Zyrter/super-osd/hardware/V3.25 Lite/note about refdeses.txt

Due to a bit of screwup while designing this version, I numbered all resistors from R16 and all capacitors from C18. There are no missing components, it was just a mistake on my part. I'm not too bothered by this but I will fix it in future versions.

Tom
