Zyrter/super-osd/hardware/Basic Main Board Schematic.png

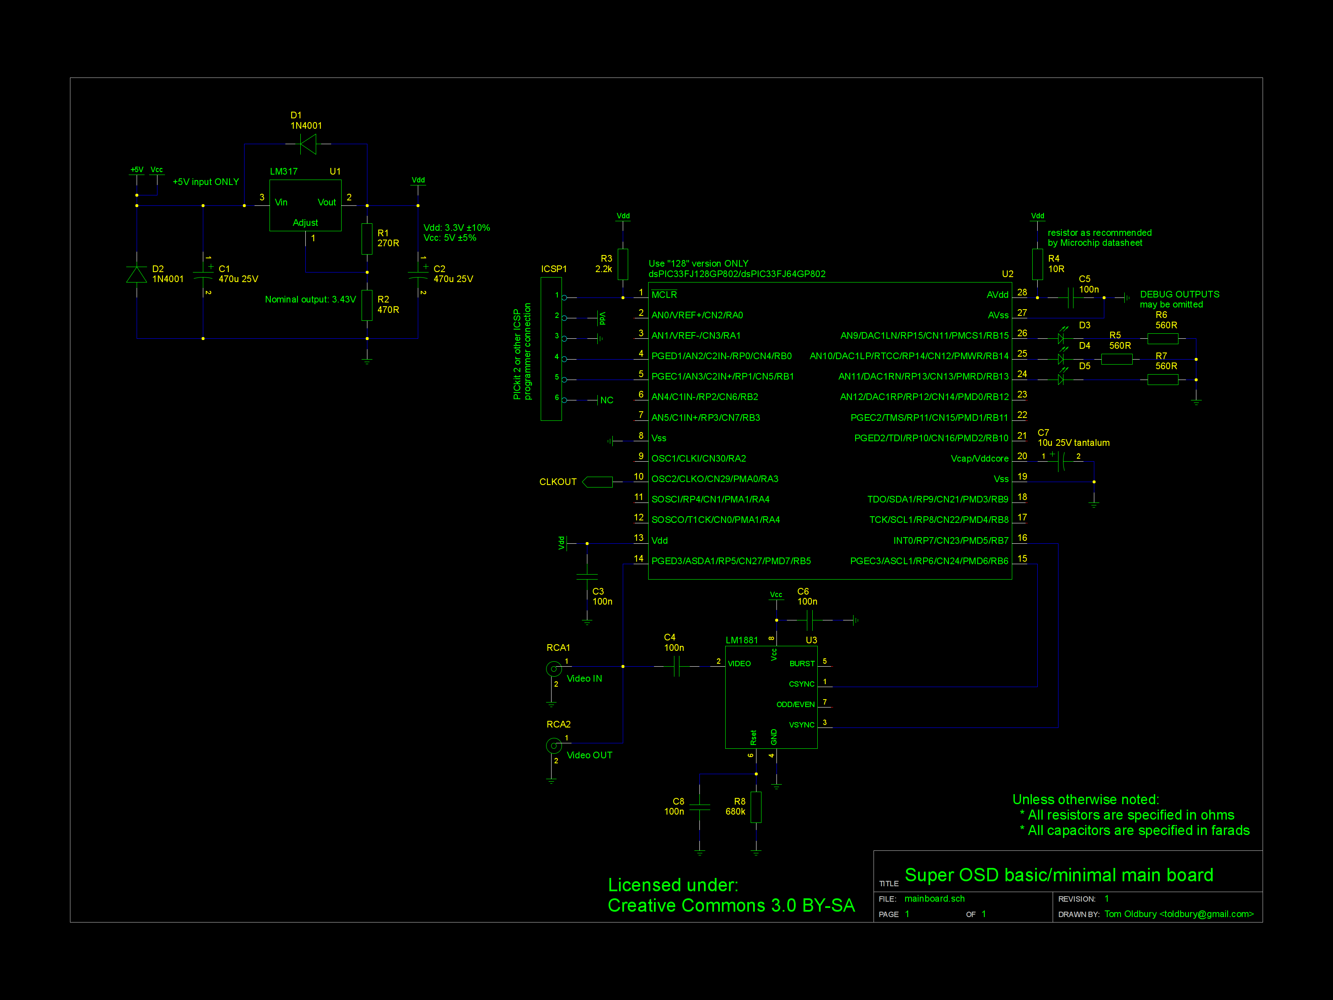
hardware/Basic Main Board Schematic.png
