Zyrter/super-osd/hardware/Other Stuff/Gaming Radio/gaming-radio.png

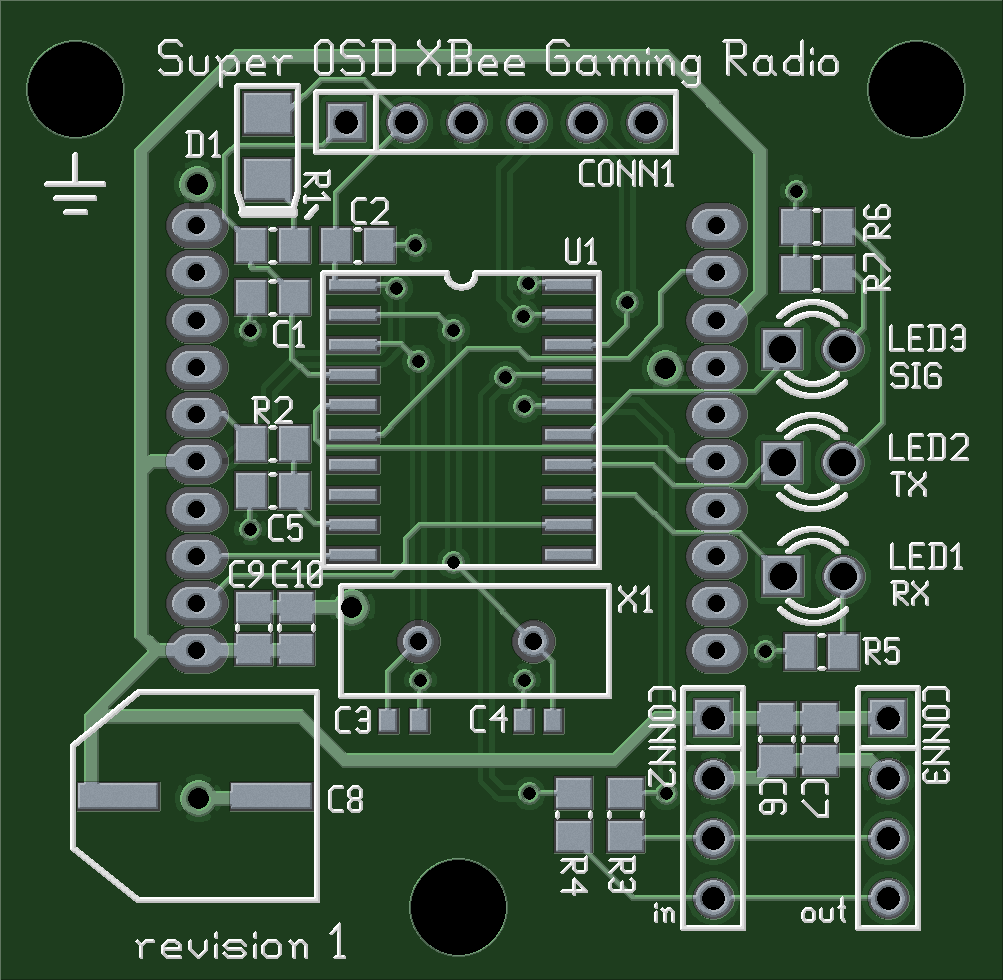
hardware/Other Stuff/Gaming Radio/gaming-radio.png
