Zyrter/super-osd/hardware/Other Stuff/Gaming Radio/radio.png

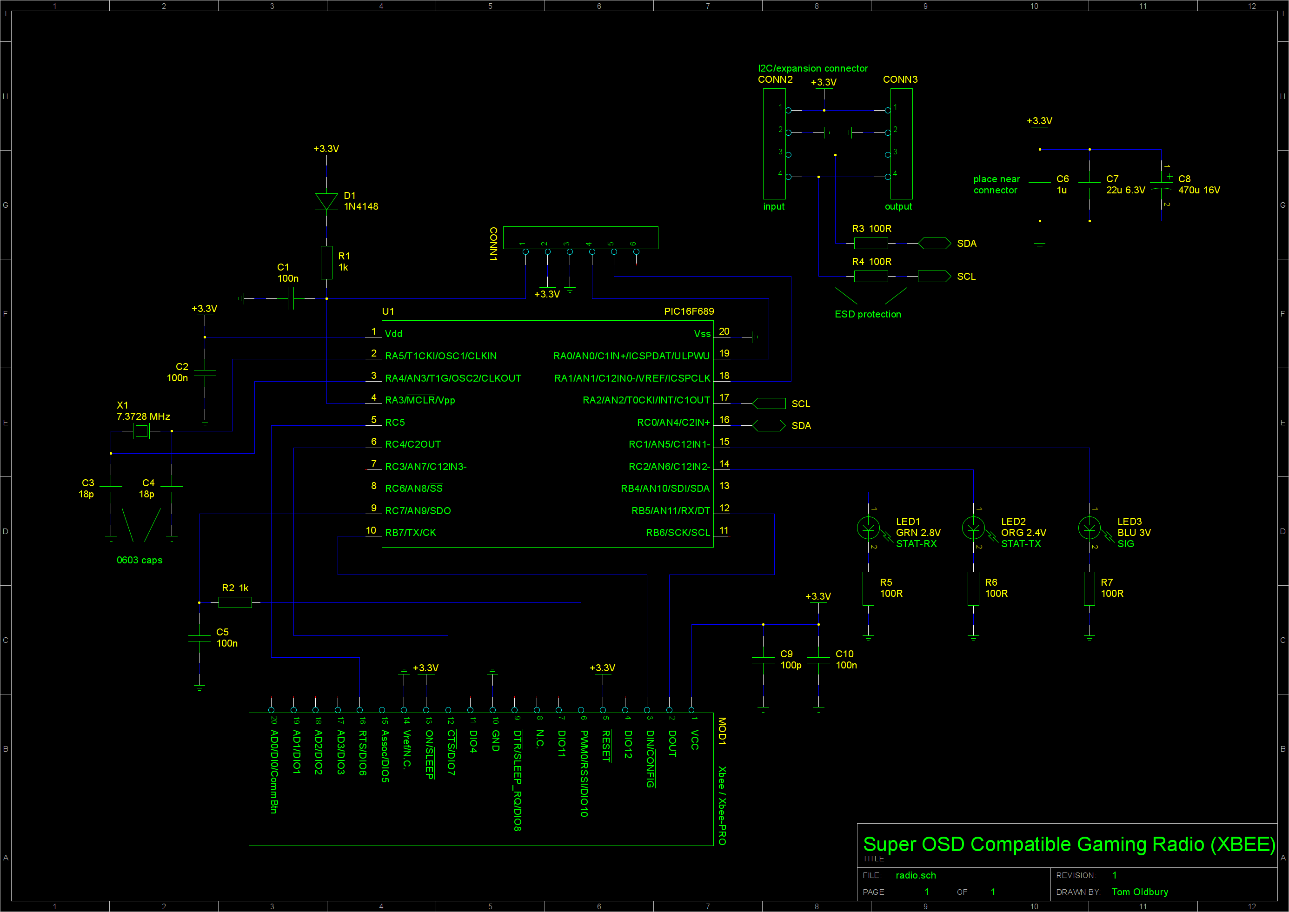
hardware/Other Stuff/Gaming Radio/radio.png
