Zyrter/super-osd/hardware/V2 (FPV version)/FPV_version_analog_inputs.png

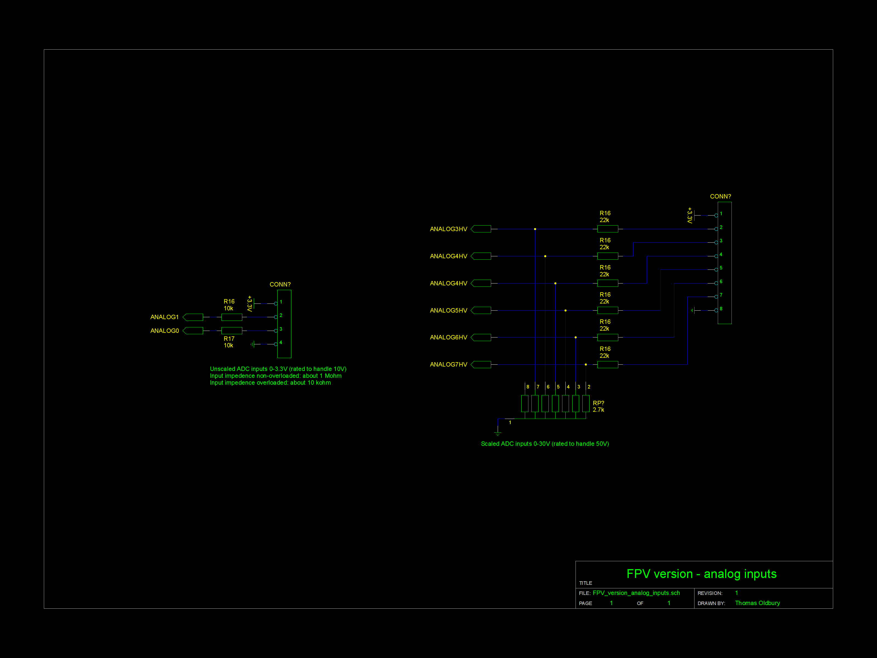
hardware/V2 (FPV version)/FPV_version_analog_inputs.png
