Zyrter/super-osd/hardware/V2 (FPV version)/FPV_version_external_interface.png

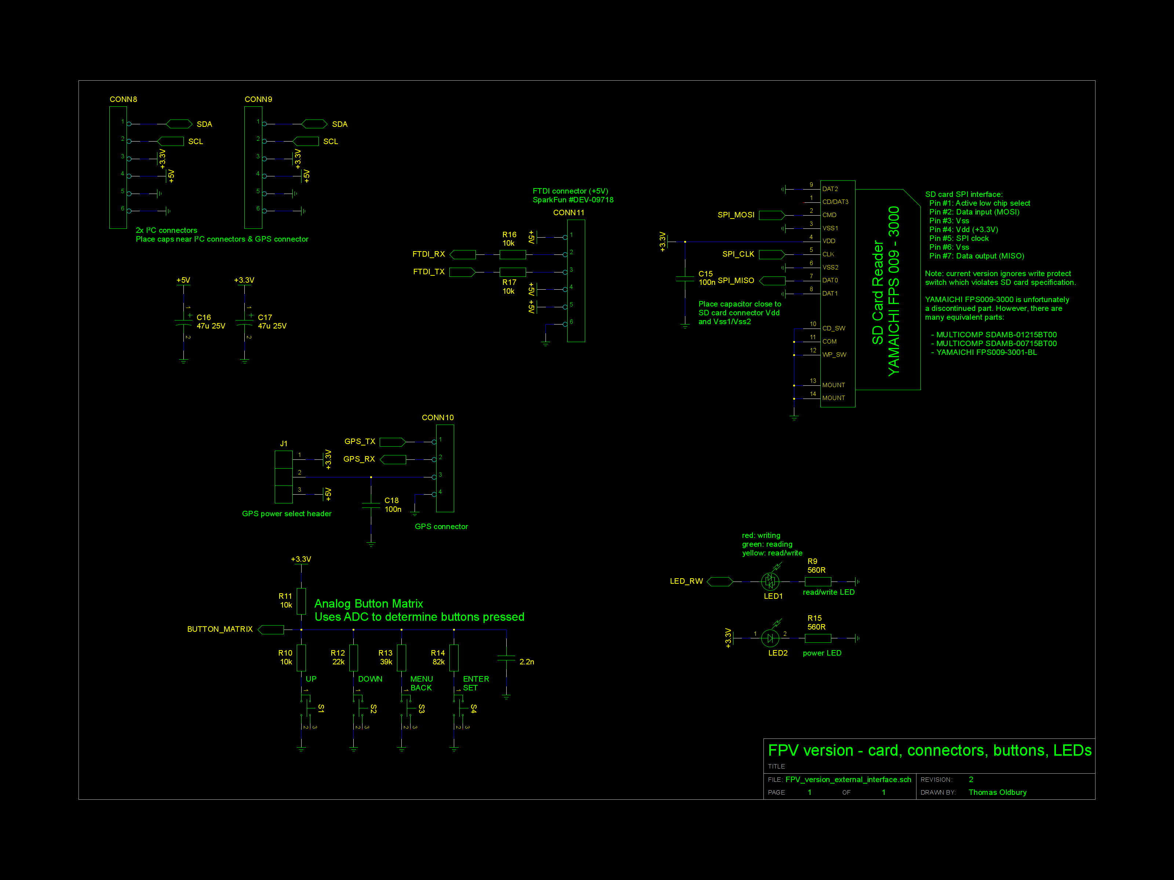
hardware/V2 (FPV version)/FPV_version_external_interface.png
