Zyrter/super-osd/hardware/V2 (FPV version)/FPV_version_PIC18.png

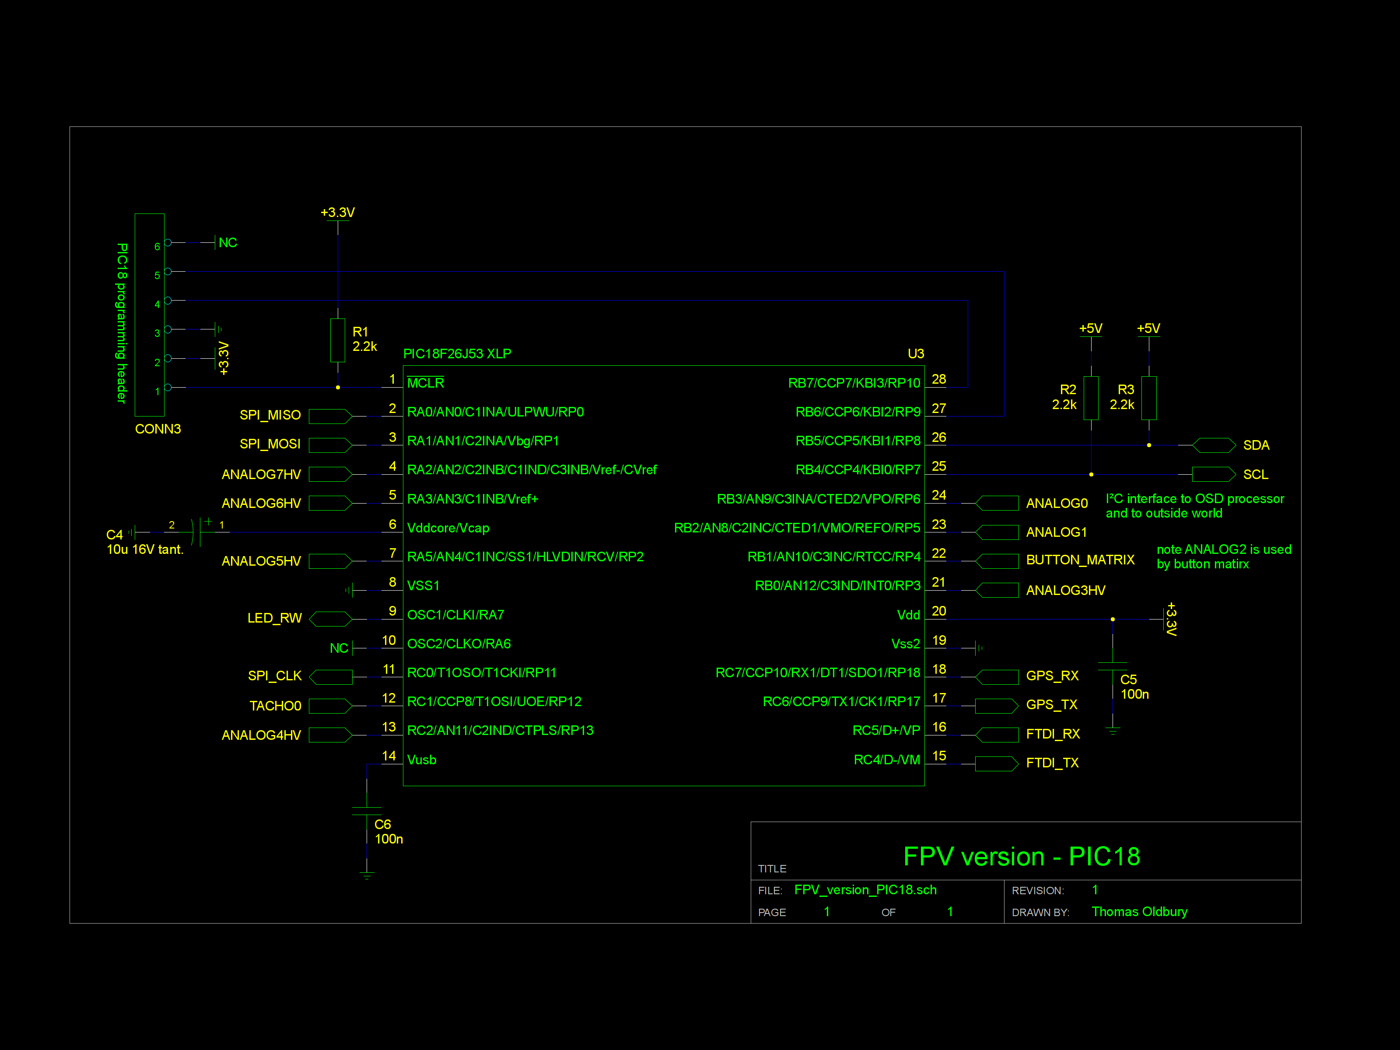
hardware/V2 (FPV version)/FPV_version_PIC18.png
