Zyrter/super-osd/hardware/V2 (FPV version)/FPV_version_video_core.png

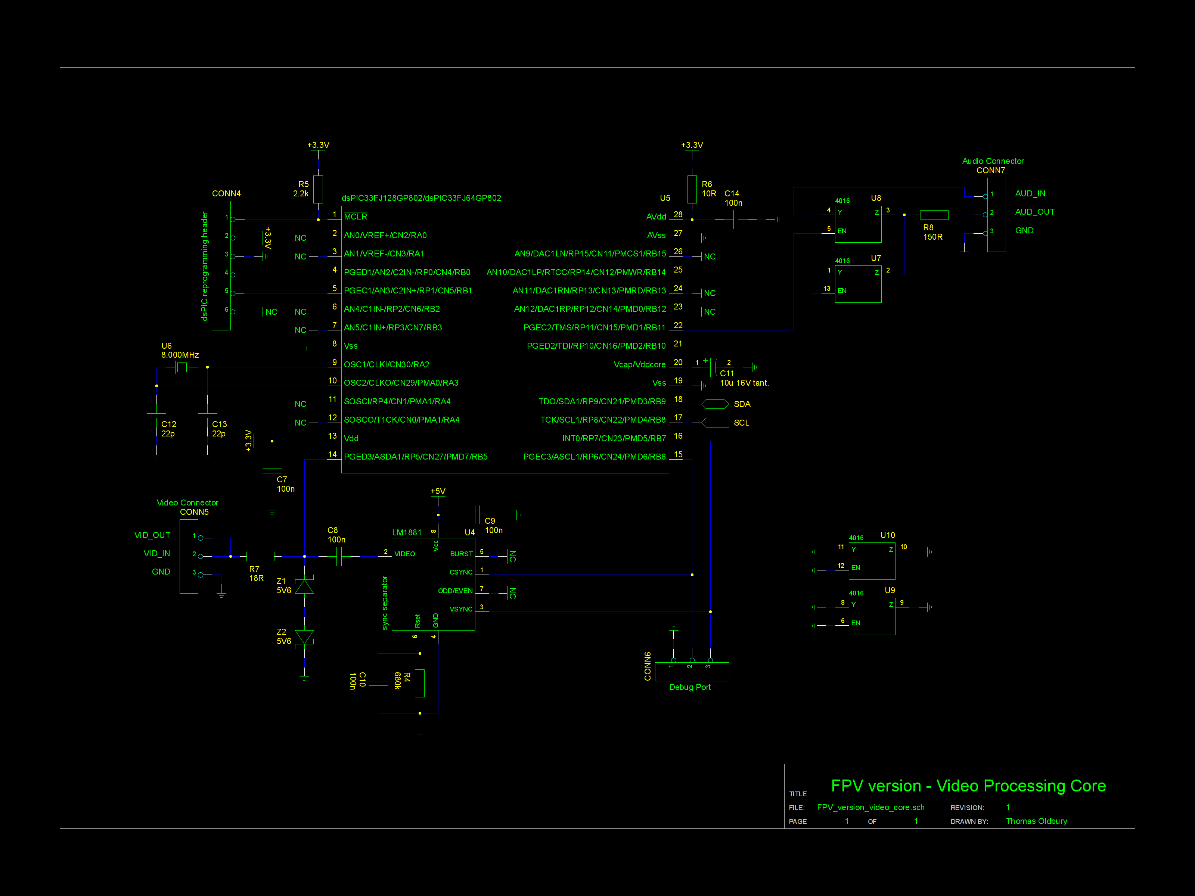
hardware/V2 (FPV version)/FPV_version_video_core.png
