Zyrter/super-osd/hardware/V2 (FPV version)/Power_supply_section.png

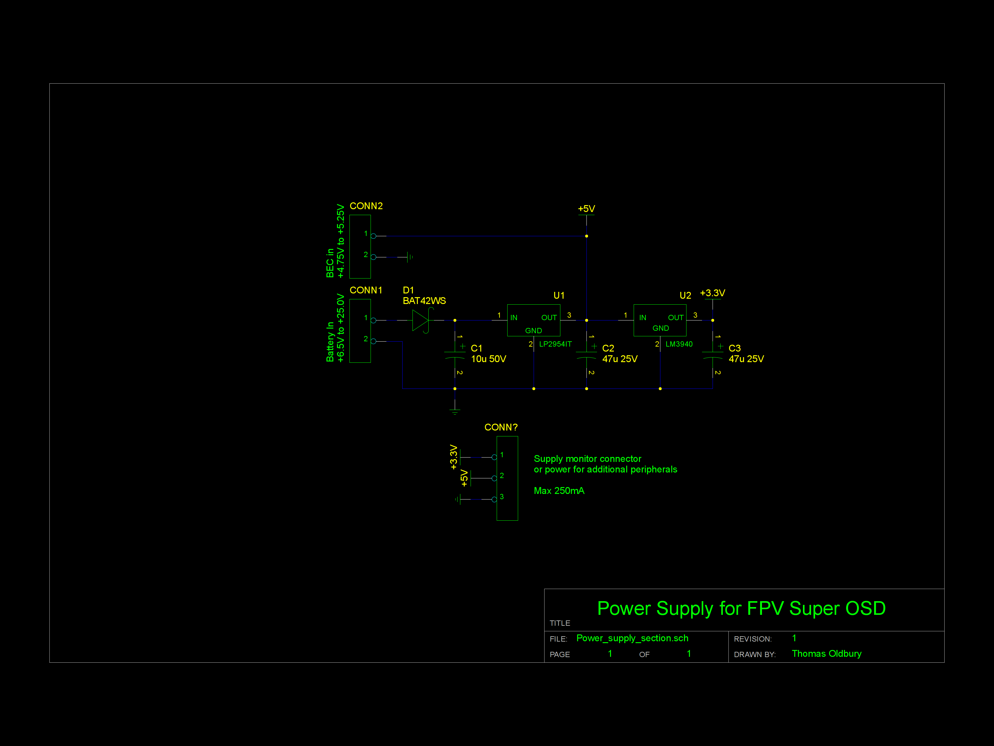
hardware/V2 (FPV version)/Power_supply_section.png
