Zyrter/super-osd/hardware/V2B (Final-Prototype)/FPV_version_analog_inputs.png

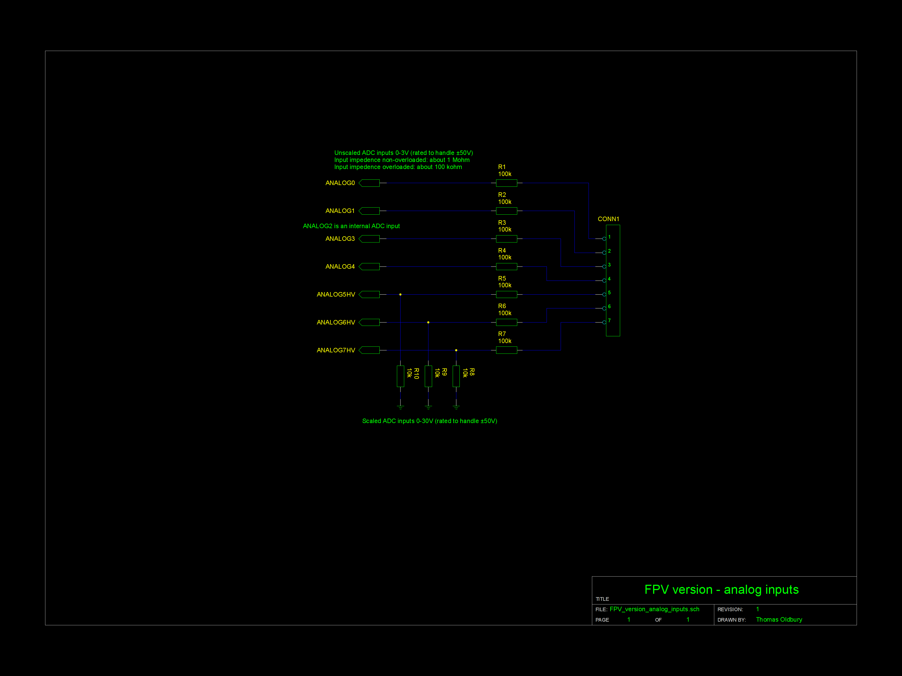
hardware/V2B (Final-Prototype)/FPV_version_analog_inputs.png
