Zyrter/super-osd/hardware/V2B (Final-Prototype)/FPV_version_external_interface.png

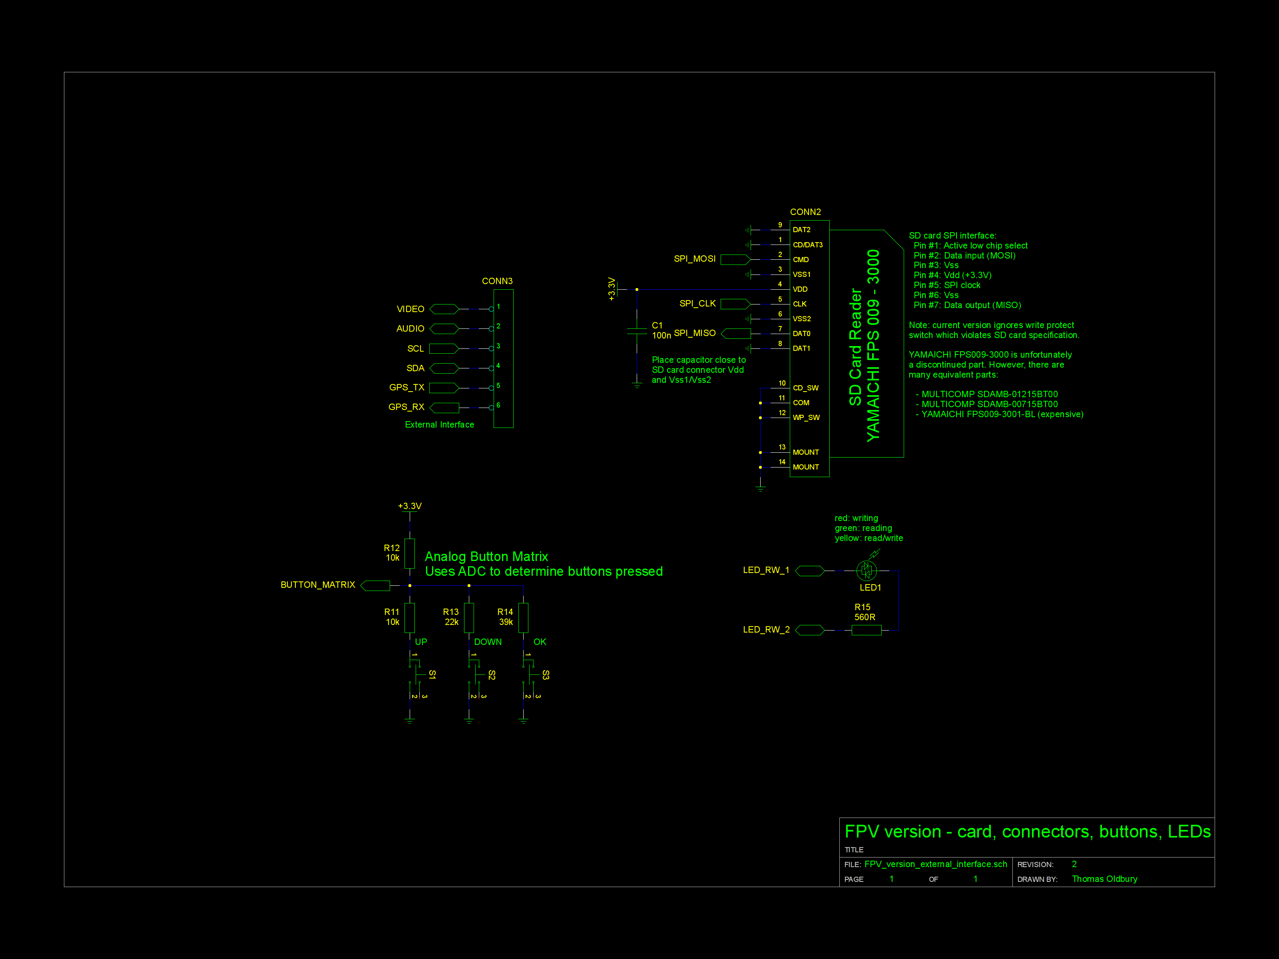
hardware/V2B (Final-Prototype)/FPV_version_external_interface.png
