Zyrter/super-osd/hardware/V2B (Final-Prototype)/FPV_version_video_core.png

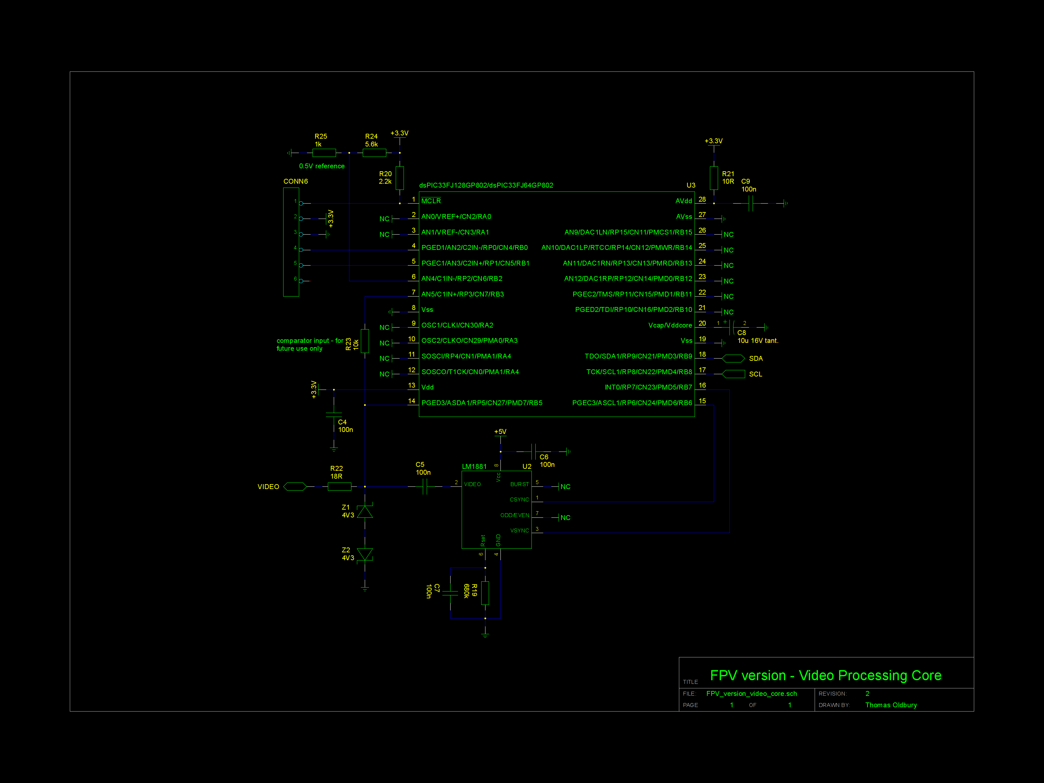
hardware/V2B (Final-Prototype)/FPV_version_video_core.png
