Zyrter/super-osd/hardware/V2B (Final-Prototype)/Power_supply_section.png

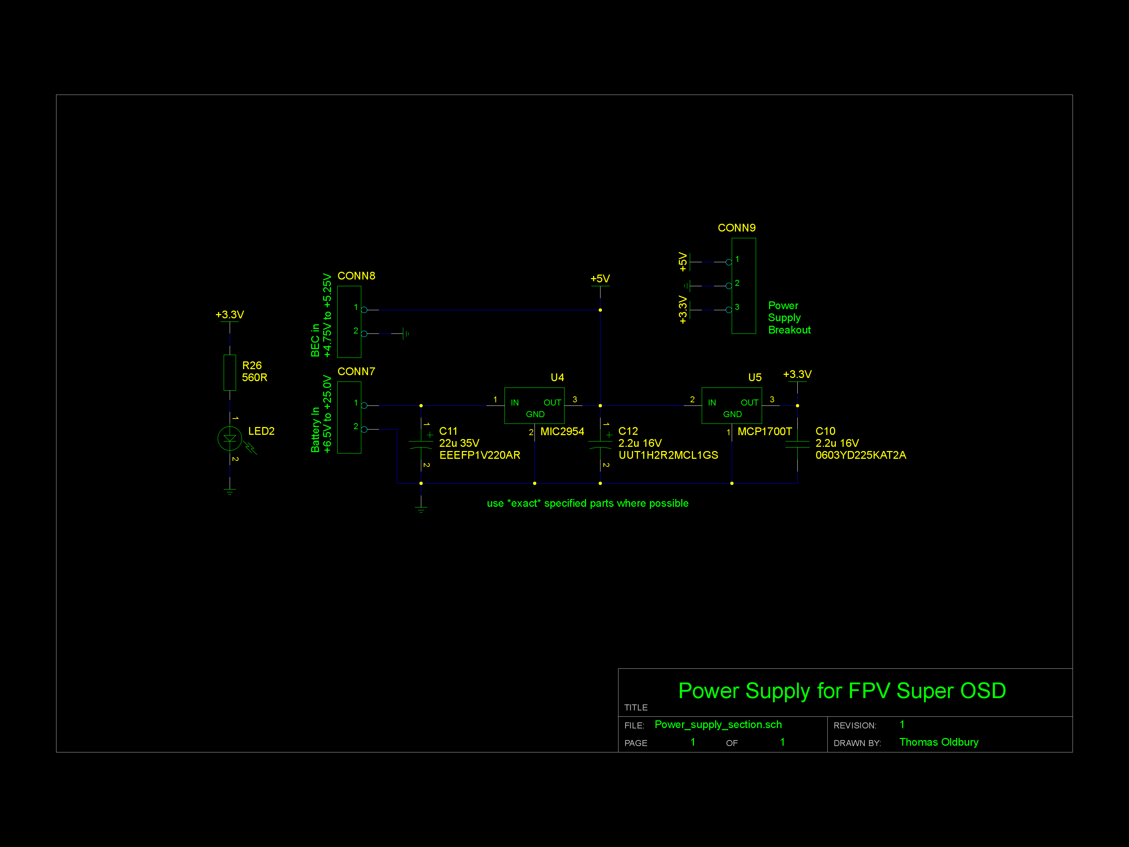
hardware/V2B (Final-Prototype)/Power_supply_section.png
