Zyrter/super-osd/hardware/V2B (Final-Prototype)/v2b_bottom.png

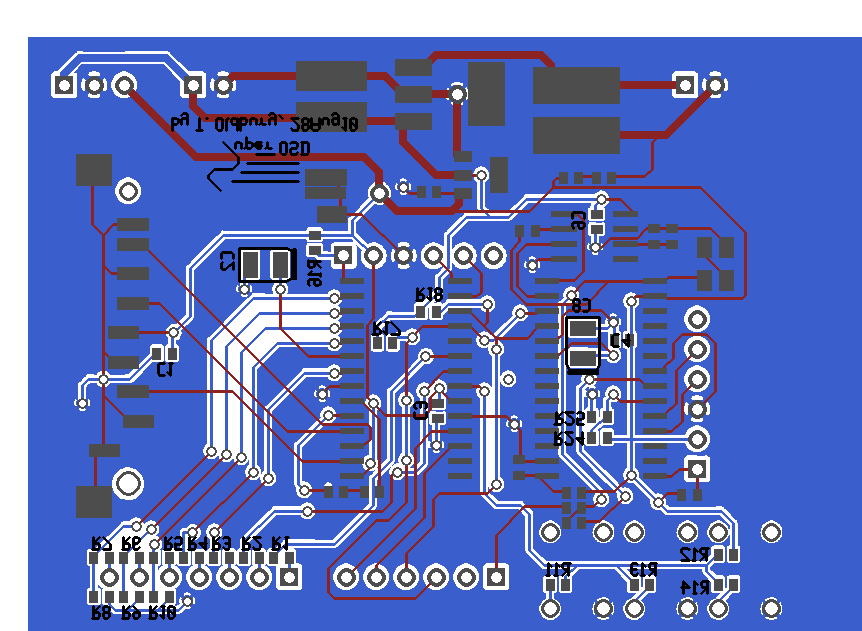
hardware/V2B (Final-Prototype)/v2b_bottom.png
