Zyrter/super-osd/hardware/V2B (Final-Prototype)/v2b_top.png

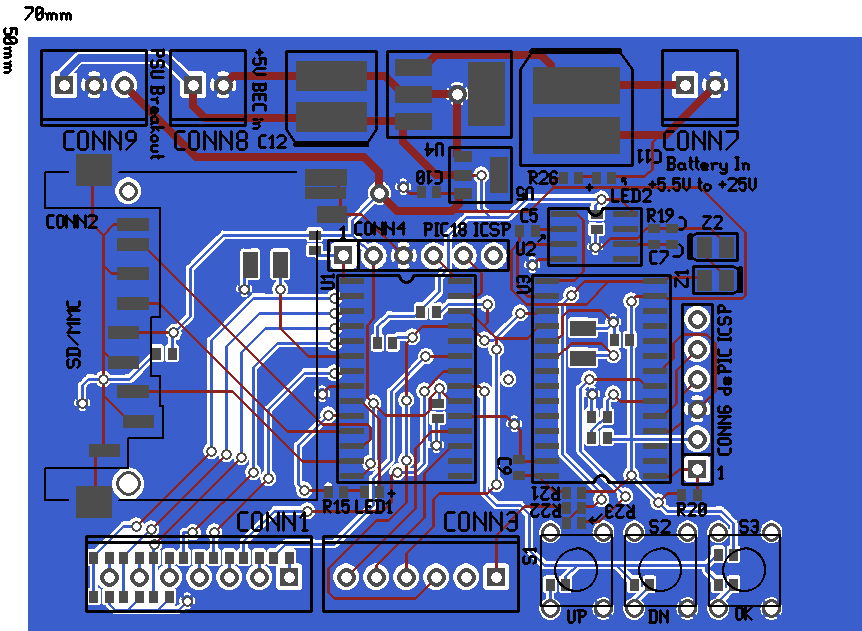
hardware/V2B (Final-Prototype)/v2b_top.png
