Zyrter/super-osd/hardware/V3.25 Lite/buttons-and-illumination.png

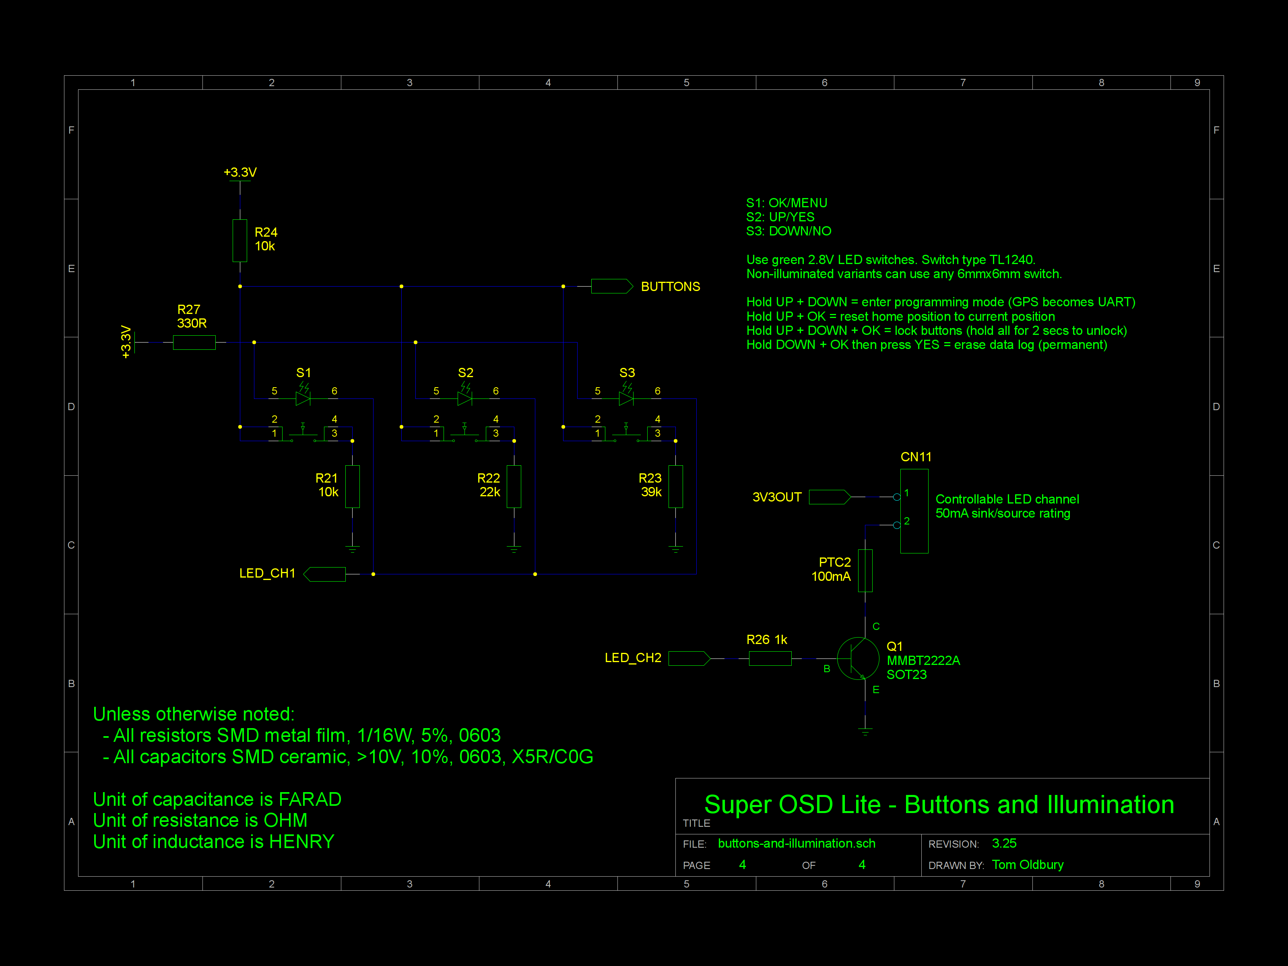
hardware/V3.25 Lite/buttons-and-illumination.png
