Zyrter/super-osd/hardware/V3.25 Lite/mcu.png

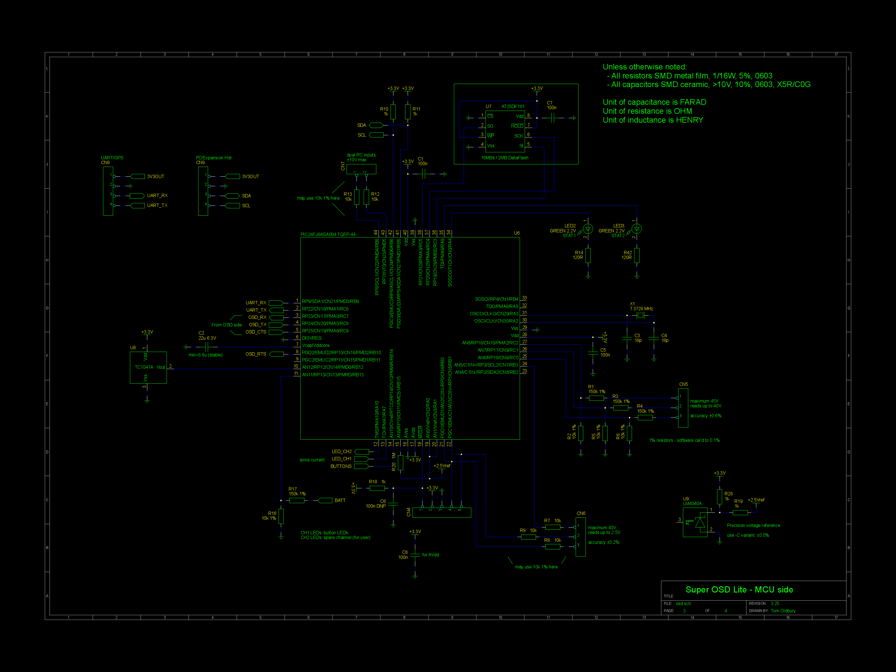
hardware/V3.25 Lite/mcu.png
