Zyrter/super-osd/hardware/V3.25 Lite/osd.png

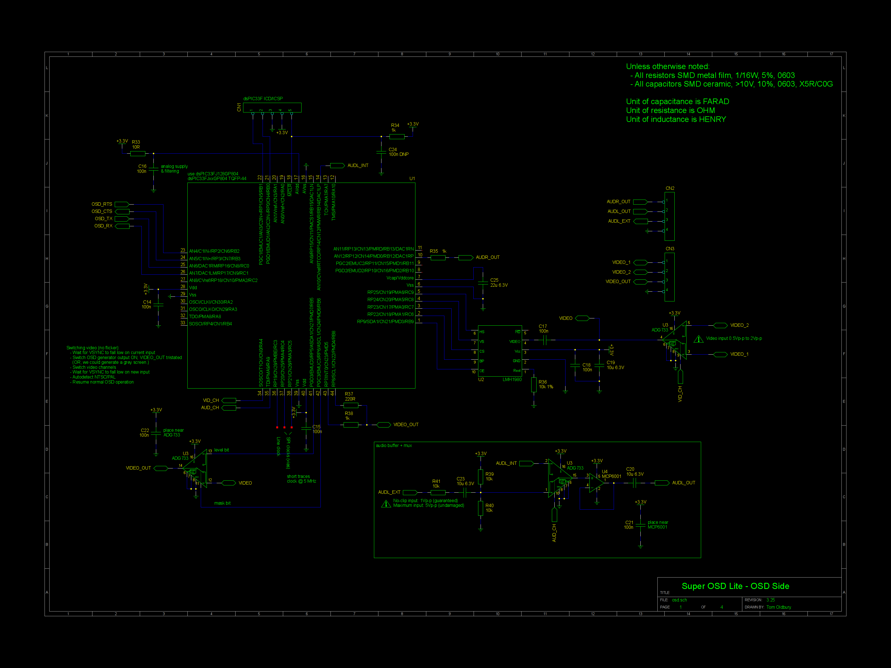
hardware/V3.25 Lite/osd.png
