Zyrter/super-osd/hardware/V3.25 Lite/pcb-v3.25-lite.top.png

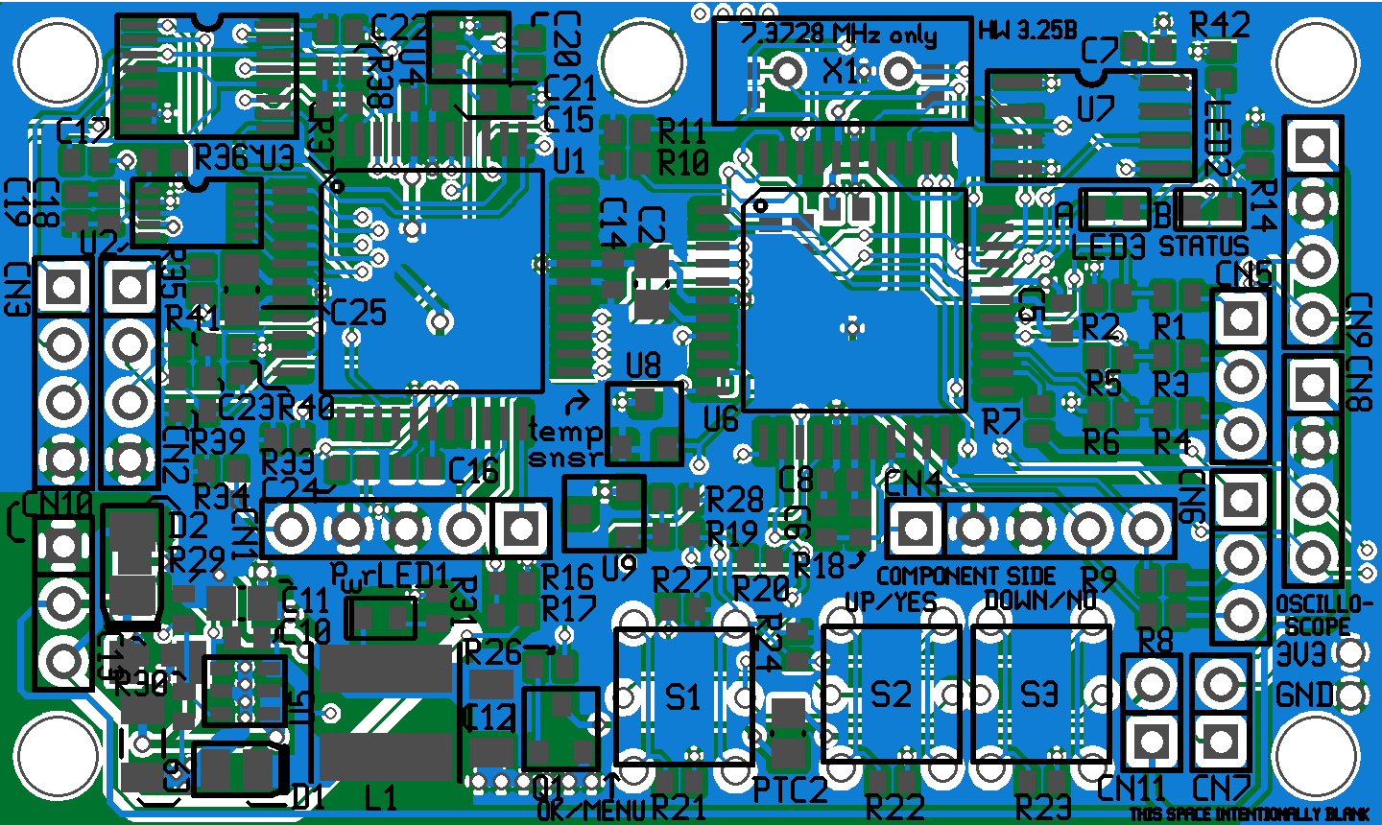
hardware/V3.25 Lite/pcb-v3.25-lite.top.png
