Zyrter/super-osd/hardware/V3.25 Lite/power.png

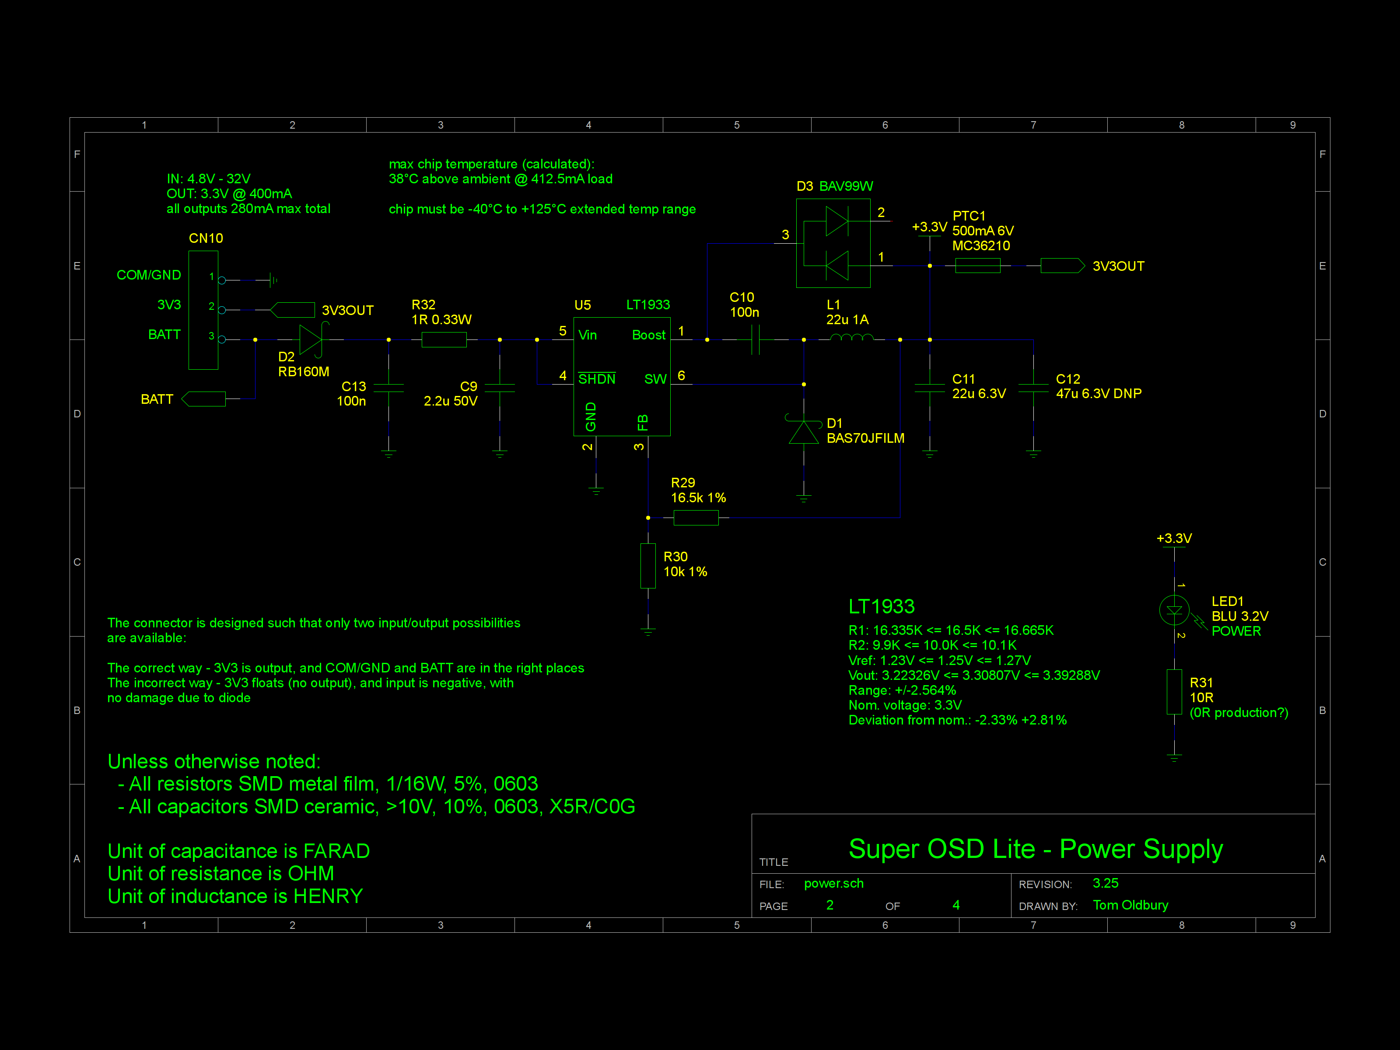
hardware/V3.25 Lite/power.png
