Zyrter/super-osd/hardware/V2B (Final-Prototype)/bom.ods

BILL OF MATERIALS FOR (r4: FPV version)
SUPPLIER: FARNELL (UK) EXCEPT WHERE NOTED
FOR SMALL QUANTITIES (<10 units) ONLY
RefDes | Value | Footprint | Unit price (inc VAT) | Order Code | Notes
C1 | 100n | 0603 | £0.0050 | 1759016 | Min order 100
C2 | 10u 16V tant. | EIA3216 | £0.4700 | 1462407 | High reliability, down to -55°C, low ESR ~3ohm
C3 | 100n | 0603 | £0.0050 | 1759016 | Min order 100
C4 | 100n | 0603 | £0.0050 | 1759016 | Min order 100
C5 | 100n | 0603 | £0.0050 | 1759016 | Min order 100
C6 | 100n | 0603 | £0.0050 | 1759016 | Min order 100
C7 | 100n | 0603 | £0.0050 | 1759016 | Min order 100
C8 | 10u 16V tant. | EIA3216 | £0.4700 | 1462407 | High reliability, down to -55°C, low ESR ~3ohm
C9 | 100n | 0603 | £0.0050 | 1759016 | Min order 100
C10 | 2.2u 16V | 0603 | £0.6500 | 1458897 | As specified: 0603YD225KAT2A
C11 | 22u 35V | SME5 | £0.4400 | 1539494 | As specified: EEEFP1V220AR
C12 | 2.2u 16V | SME4 | £0.4000 | 8823251 | As specified: UUT1H2R2MCL1GS
CONN1 |  | MTA100_7 | £1.3200 | 1272217
CONN2 |  | sdcard-1 | £1.0100 | 9186140 | MULTICOMP – SDAMB-01215BT00, low cost SD card holder
CONN3 |  | MTA100_6 | £0.8500 | 1272213
CONN4 |  | JUMPER6 | £0.4800 | 9731113 | Min order 10; Quality Molex part(?) (HEADER, SQUARE PIN, 0.1", 6WAY)
CONN6 |  | JUMPER6 | £0.4800 | 9731113 | Min order 10; Quality Molex part(?) (HEADER, SQUARE PIN, 0.1", 6WAY)
CONN7 |  | MTA100_2 | £0.3050 | 1199343
CONN8 |  | MTA100_2 | £0.2980 | 1325021
CONN9 |  | MTA100_3 | £0.2980 | 1325021
LED1 |  | 0603 | £0.1060 | 1652080 | Bicolour not yet available – chosen RED instead to indicate writing
LED2 |  | 0603 | £0.1060 | 1652080 | Red LED for power
R1 | 10k | 0603 | £0.0230 | 9330402 | Min order 50, input protection resistor, tolerance not an issue (±5% or better)
R2 | 10k | 0603 | £0.0230 | 9330402 | Min order 50, input protection resistor, tolerance not an issue (±5% or better)
R3 | 10k | 0603 | £0.0230 | 9330402 | Min order 50, input protection resistor, tolerance not an issue (±5% or better)
R4 | 10k | 0603 | £0.0230 | 9330402 | Min order 50, input protection resistor, tolerance not an issue (±5% or better)
R5 | 100k | 0603 | £0.4700 | 1577632 | Min order 5, tolerance is ±0.1% (R5..R10 used as precision dividers for voltage input)
R6 | 100k | 0603 | £0.4700 | 1577632 | Min order 5, tolerance is ±0.1% (R5..R10 used as precision dividers for voltage input)
R7 | 100k | 0603 | £0.4700 | 1577632 | Min order 5, tolerance is ±0.1% (R5..R10 used as precision dividers for voltage input)
R8 | 10k | 0603 | £0.4700 | 1577619 | Min order 5, tolerance is ±0.1% (R5..R10 used as precision dividers for voltage input)
R9 | 10k | 0603 | £0.4700 | 1577619 | Min order 5, tolerance is ±0.1% (R5..R10 used as precision dividers for voltage input)
R10 | 10k | 0603 | £0.4700 | 1577619 | Min order 5, tolerance is ±0.1% (R5..R10 used as precision dividers for voltage input)
R11 | 10k | 0603 | £0.0230 | 9330402 | Min order 50, ±5% or better
R12 | 10k | 0603 | £0.0230 | 9330402 | Min order 50, ±5% or better
R13 | 22k | 0603 | £0.0230 | 9330828 | Min order 50, ±5% or better
R14 | 39k | 0603 | £0.0120 | 9332111 | Min order 50, ±5% or better
R15 | 560R | 0603 | £0.0120 | 9332200 | Min order 50, ±5% or better
R16 | 2.2k | 0603 | £0.0230 | 9330810 | Min order 50, ±5% or better
R17 | 2.2k | 0603 | £0.0230 | 9330810 | Min order 50, ±5% or better
R18 | 2.2k | 0603 | £0.0230 | 9330810 | Min order 50, ±5% or better
R19 | 680k | 0603 | £0.0230 | 9331476 | Min order 50, ±5% or better
R20 | 2.2k | 0603 | £0.0230 | 9330810 | Min order 50, ±5% or better
R21 | 10R | 0603 | £0.0230 | 9330429 | Min order 50, ±5% or better
R22 | 18R | 0603 | £0.0120 | 9331840 | Min order 50, ±5% or better
R23 | 10k | 0603 | £0.0230 | 9330402 | Min order 50, ±5% or better
R24 | 5.6k | 0603 | £0.0230 | 9331352 | Min order 50, ±5% or better
R25 | 1k | 0603 | £0.0230 | 9330380 | Min order 50, ±5% or better
R26 | 560R | 0603 | £0.0120 | 9332200 | Min order 50, ±5% or better
S1 |  | SPDT_button | £0.2600 | 1217773 | High reliability through-hole tactile Schurter switches, 5mm, with land pattern (6.5mmx4.5mm)
S2 |  | SPDT_button | £0.2600 | 1217773 | High reliability through-hole tactile Schurter switches, 5mm, with land pattern (6.5mmx4.5mm)
S3 |  | SPDT_button | £0.2600 | 1217773 | High reliability through-hole tactile Schurter switches, 5mm, with land pattern (6.5mmx4.5mm)
U1 |  | SO28 | £2.2500 | PIC18F26J53-I/SO | Order from Microchip Direct
U2 |  | SO8 | £2.6500 | 9493468 | Sync sep (LM1881)
U3 |  | SO28 | £3.7600 | DSPIC33FJ128GP802-E/SO | Order from Microchip Direct
U4 |  | SOT223 | £2.2300 | 1556741 | +5V regulator
U5 |  | SOT89 | £0.2500 | MCP1700T-3302E/MB | Order from Microchip Direct
Z1 | 4V3 | SOD323 | £0.0760 | 8735697 | Min order 10, zener, 300mW dissipation
Z2 | 4V3 | SOD323 | £0.0760 | 8735697 | Min order 10, zener, 300mW dissipation
