Zyrter/super-osd/hardware/Other Stuff/Factory Calibrator/cal-board.png

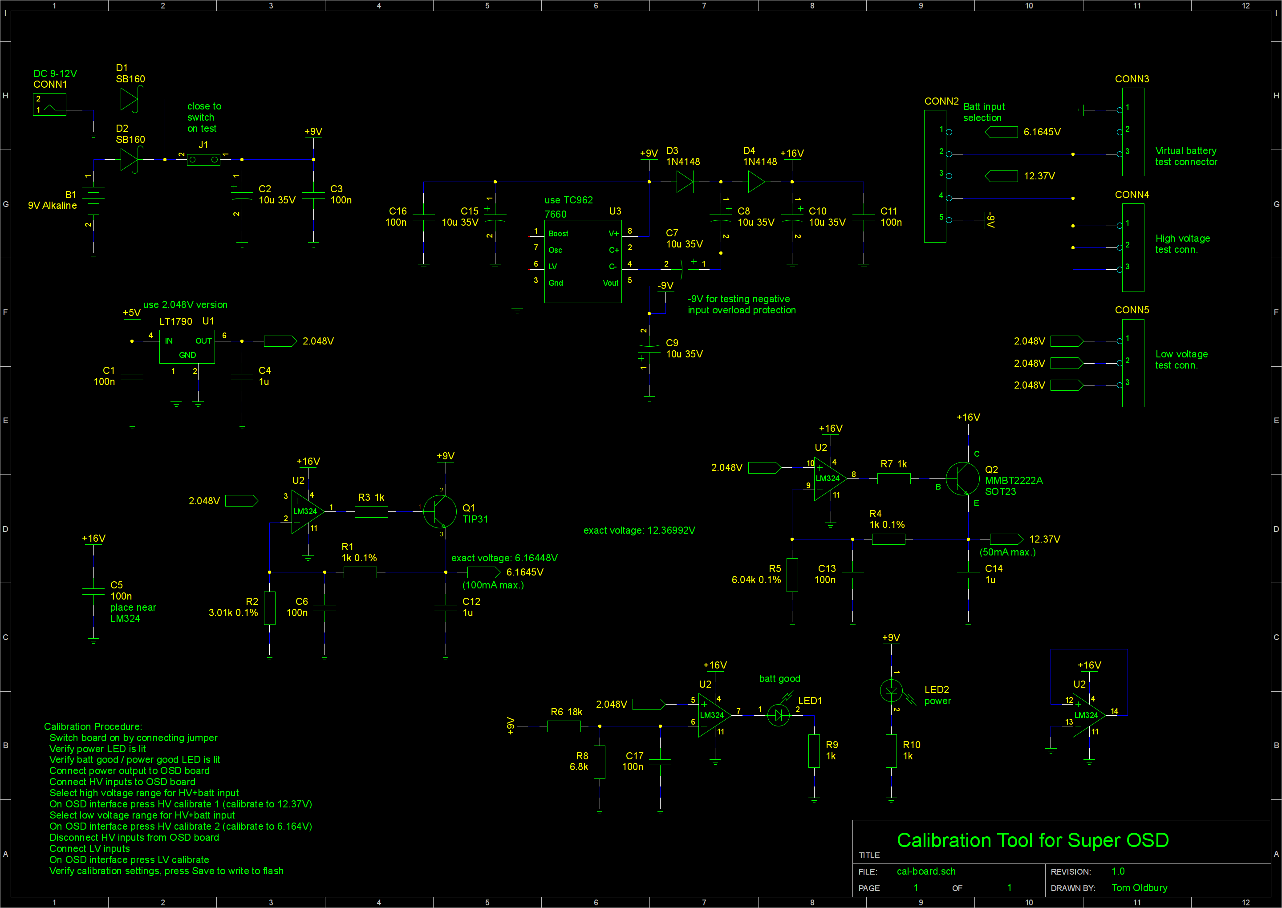
hardware/Other Stuff/Factory Calibrator/cal-board.png
