Zyrter/super-osd/hardware/Other Stuff/Factory Calibrator/v1.png

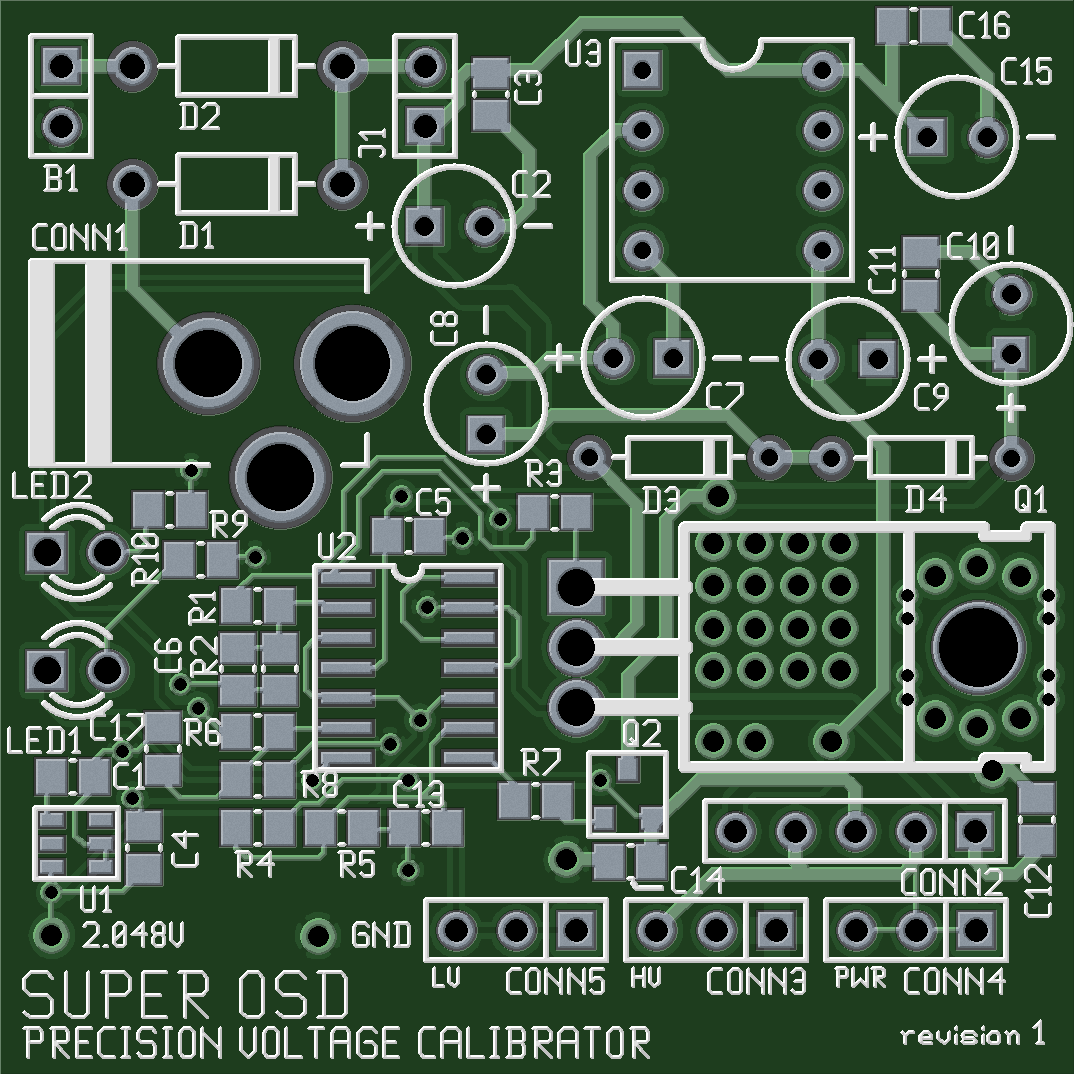
hardware/Other Stuff/Factory Calibrator/v1.png
