Zyrter/super-osd/(list of files, drawings)

Other design files:
hardware/Other Stuff/Factory Calibrator/v1.pcb
hardware/Other Stuff/Gaming Radio/gaming-radio.pcb
hardware/V2 (FPV version)/PCBs/FPV_version.pcb
hardware/V2B (Final-Prototype)/v2b.pcb
hardware/V3 Lite/pcb-v3-lite.pcb
hardware/V3.2 Lite/pcb-v3-lite.pcb
hardware/V3.3 Lite/pcb-v3.3-lite.pcb
hardware/V3.25 Lite/pcb-v3.25-lite.pcb
