Zyrter/super-osd/src-new/V3.2/gfx.c

/**
 * Super OSD, software revision 3
 * Copyright (C) 2010 Thomas Oldbury
 *
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
 * You should have received a copy of the GNU General Public License along
 * with this program; if not, write to the Free Software Foundation, Inc.,
 * 51 Franklin Street, Fifth Floor, Boston, MA 02110-1301 USA.
 */

// used by some debug code
long int delaytmp;
long int delayhowlong; 

#include "gfx.h"
#include "useful.h"
#include "fonts.h"

#include <stdlib.h>
#include <ctype.h>

/**
 * The GFX files handle the management of the display surfaces. 
 * They implement the basic drawing functions and the display
 * buffers. But, they do not handle the actual OSD output or 
 * timing; that is managed by the OSD files.
 */

// Define the buffers.
// For 256x192 pixel mode:
//   buffer0_level/buffer0_mask becomes buffer_level; and 
//   buffer1_level/buffer1_mask becomes buffer_mask;
// For 192x128 pixel mode, allocations are as the names are written.
// divide by 8 because two bytes to a word.
// Must be allocated in one block, so it is in a struct.
struct _buffers
{
	uint16_t buffer0_level[BUFF_TOTAL_SIZE / 8] FAR;
	uint16_t buffer0_mask[BUFF_TOTAL_SIZE / 8] FAR;
	uint16_t buffer1_level[BUFF_TOTAL_SIZE / 8] FAR;
	uint16_t buffer1_mask[BUFF_TOTAL_SIZE / 8] FAR;
} buffers FAR;
// Remove the struct definition (makes it easier to write for.)
#define		buffer0_level	(buffers.buffer0_level)
#define		buffer0_mask	(buffers.buffer0_mask)
#define		buffer1_level	(buffers.buffer1_level)
#define		buffer1_mask	(buffers.buffer1_mask)

int disp_width, disp_height, disp_mode;
int buff_words;

// We define pointers to each of these buffers.
uint16_t *draw_buffer_level;
uint16_t *draw_buffer_mask;
uint16_t *disp_buffer_level;
uint16_t *disp_buffer_mask;

// Memory test.
int memseed;

// Do we have VSYNC, and are we looking for it? (osd.c sets have_vsync_refresh, gfx.c clears it.)
// Some graphics work better locked to the frame rate, so we have functions to wait for vsync.
int use_vsync, have_vsync_refresh;

/**
 * init_osd: Initialize the OSD buffers and internal 
 * state variables.
 */
void init_gfx(int mode)
{
	// mode 0: hires
	if(mode == 0)
	{
		draw_buffer_level = buffer0_level;
		draw_buffer_mask = buffer1_level; // see above
		disp_buffer_level = draw_buffer_level;
		disp_buffer_mask = draw_buffer_mask;
		buff_words = BUFF_TOTAL_SIZE / 4;
		disp_width = 240;
		disp_height = 208; 
		disp_mode = 0;
	}
	// mode 1: lores
	else if(mode == 1)
	{
		draw_buffer_level = buffer0_level;
		draw_buffer_mask = buffer0_mask;
		disp_buffer_level = buffer1_level;
		disp_buffer_mask = buffer1_mask;
		buff_words = BUFF_TOTAL_SIZE / 8;
		disp_width = 192;
		disp_height = 128; 
		disp_mode = 1;
	}
	// Fill the buffers with empty data, in case the RAM doesn't
	// initialize empty.
	fill_buffer(draw_buffer_level, 0x0000);
	fill_buffer(draw_buffer_mask, 0x0000);
	fill_buffer(disp_buffer_level, 0x0000);
	fill_buffer(disp_buffer_mask, 0x0000);
	// Memory test seed - initialize it to zero.
	memseed = 0;
	// Don't use vsync for now.
	use_vsync = 0;
	have_vsync_refresh = 1;
	// Default debug delay period (not often used.)
	delayhowlong = 10;
}

/**
 * mem_test: Test memory (level and mask) by writing a word 
 * and reading it back. Uses draw buffer only.
 *
 * @return	Number of errors (0 = none)
 */
volatile int mem_test(uint16_t word)
{
	int i = buff_words, err = 0;
	uint16_t *buff = draw_buffer_level;
	while(i--)
	{
		*buff = word;
		if(*buff != word)
			err++;
		*buff++;
	}
	buff = draw_buffer_mask;
	i = buff_words;
	while(i--)
	{
		*buff = word;
		if(*buff != word)
			err++;
		*buff++;
	}
	return err;
}

/**
 * mem_test_full: Fully test memory.
 *
 * @return	0 = failure, 1 = success
 */
int mem_test_full()
{
	#define DO_MEM_TEST_WORD(x) \
		if(mem_test((x))) { goto memtest_error; } \
		if(mem_test((x))) { goto memtest_error; } \
		swap_buffers(); \
		if(mem_test((x))) { goto memtest_error; } \
		if(mem_test((x))) { goto memtest_error; } \
		swap_buffers();
	
	// Simple on/off bit tests
	DO_MEM_TEST_WORD(0b1111111111111111);
	DO_MEM_TEST_WORD(0b0000000000000000);
	DO_MEM_TEST_WORD(0b1010101010101010);
	DO_MEM_TEST_WORD(0b0101010101010101);
	DO_MEM_TEST_WORD(0b1100110011001100);
	DO_MEM_TEST_WORD(0b0011001100110011);
	DO_MEM_TEST_WORD(0b1111000011110000);
	DO_MEM_TEST_WORD(0b0000111100001111);
	DO_MEM_TEST_WORD(0b1111111100000000);
	DO_MEM_TEST_WORD(0b0000000011111111);
	DO_MEM_TEST_WORD(0b1111111111111111);
	DO_MEM_TEST_WORD(0b0000000000000000);
	// Roaming bit tests
	DO_MEM_TEST_WORD(0b1000000000000000);
	DO_MEM_TEST_WORD(0b0100000000000000);
	DO_MEM_TEST_WORD(0b0010000000000000);
	DO_MEM_TEST_WORD(0b0001000000000000);
	DO_MEM_TEST_WORD(0b0000100000000000);
	DO_MEM_TEST_WORD(0b0000010000000000);
	DO_MEM_TEST_WORD(0b0000001000000000);
	DO_MEM_TEST_WORD(0b0000000100000000);
	DO_MEM_TEST_WORD(0b0000000010000000);
	DO_MEM_TEST_WORD(0b0000000001000000);
	DO_MEM_TEST_WORD(0b0000000000100000);
	DO_MEM_TEST_WORD(0b0000000000010000);
	DO_MEM_TEST_WORD(0b0000000000001000);
	DO_MEM_TEST_WORD(0b0000000000000100);
	DO_MEM_TEST_WORD(0b0000000000000001);
	// Random word tests.
	DO_MEM_TEST_WORD(rand() & 0xffff);
	DO_MEM_TEST_WORD(rand() & 0xffff);
	DO_MEM_TEST_WORD(rand() & 0xffff);
	DO_MEM_TEST_WORD(rand() & 0xffff);
	return 1;
	
	#undef DO_MEM_TEST_WORD
memtest_error:
	return 0;
}

/**
 * fill_buffer: Fill a buffer (given by a pointer)
 * with one word of data.
 */
void fill_buffer(uint16_t *buff, uint16_t word)
{
	int i = buff_words;
	while(i--)
	{
		*buff++ = word;
	}
}

/**
 * fill_buffer_rand: Fill a buffer (given by a pointer)
 * with random data.
 */
void fill_buffer_rand(uint16_t *buff)
{
	int i = buff_words;
	while(i--)
	{
		*buff++ = rand() + rand();
	}
}

/**
 * clear_draw: Erase the draw buffers.
 */
void clear_draw()
{
	fill_buffer(draw_buffer_level, 0x0000);
	fill_buffer(draw_buffer_mask, 0x0000);
}

/**
 * clear_disp: Erase the display buffers.
 */
void clear_disp()
{
	fill_buffer(disp_buffer_level, 0x0000);
	fill_buffer(disp_buffer_mask, 0x0000);
}

/**
 * write_pixel: Write a pixel at an x,y position to a given surface.
 *
 * @param	buff	pointer to buffer to write in
 * @param	x		x coordinate
 * @param	y		y coordinate
 * @param	mode	0 = clear bit, 1 = set bit, 2 = toggle bit
 */
void write_pixel(uint16_t *buff, unsigned int x, unsigned int y, int mode)
{
	CHECK_COORDS(x, y);
	// Determine the bit in the word to be set and the word
	// index to set it in.
	int bitnum = CALC_BIT_IN_WORD(x);
	int wordnum = CALC_BUFF_ADDR(x, y);
	// Apply a mask.
	uint16_t mask = 1 << (15 - bitnum);
	WRITE_WORD_MODE(buff, wordnum, mask, mode);
}

/**
 * write_pixel_lm: write the pixel on both surfaces (level and mask.)
 * Uses current draw buffer.
 *
 * @param	x		x coordinate
 * @param	y		y coordinate
 * @param	mmode	0 = clear, 1 = set, 2 = toggle
 * @param	lmode	0 = black, 1 = white, 2 = toggle
 */
void write_pixel_lm(unsigned int x, unsigned int y, int mmode, int lmode)
{
	CHECK_COORDS(x, y);
	// Determine the bit in the word to be set and the word
	// index to set it in.
	int bitnum = CALC_BIT_IN_WORD(x);
	int wordnum = CALC_BUFF_ADDR(x, y);
	// Apply the masks.
	uint16_t mask = 1 << (15 - bitnum);
	WRITE_WORD_MODE(draw_buffer_mask, wordnum, mask, mmode);
	WRITE_WORD_MODE(draw_buffer_level, wordnum, mask, lmode);
}

/**
 * write_hline: optimised horizontal line writing algorithm
 *
 * @param	buff	pointer to buffer to write in
 * @param	x0		x0 coordinate
 * @param	x1		x1 coordinate
 * @param	y		y coordinate
 * @param	mode	0 = clear, 1 = set, 2 = toggle
 */
void write_hline(uint16_t *buff, unsigned int x0, unsigned int x1, unsigned int y, int mode)
{
	CLIP_COORDS(x0, y);
	CLIP_COORDS(x1, y);
	if(x0 > x1)
	{
		SWAP(x0, x1);
	}
	if(x0 == x1) return;
	/* This is an optimised algorithm for writing horizontal lines. 
	 * We begin by finding the addresses of the x0 and x1 points. */
	int addr0 = CALC_BUFF_ADDR(x0, y);
	int addr1 = CALC_BUFF_ADDR(x1, y);
	int addr0_bit = CALC_BIT_IN_WORD(x0);
	int addr1_bit = CALC_BIT_IN_WORD(x1);
	int mask, mask_l, mask_r, i;
	/* If the addresses are equal, we only need to write one word
	 * which is an island. */
	if(addr0 == addr1)
	{
		mask = COMPUTE_HLINE_ISLAND_MASK(addr0_bit, addr1_bit);
		WRITE_WORD_MODE(buff, addr0, mask, mode);
	}
	/* Otherwise we need to write the edges and then the middle. */
	else
	{
		mask_l = COMPUTE_HLINE_EDGE_L_MASK(addr0_bit);
		mask_r = COMPUTE_HLINE_EDGE_R_MASK(addr1_bit);
		WRITE_WORD_MODE(buff, addr0, mask_l, mode);
		WRITE_WORD_MODE(buff, addr1, mask_r, mode);
		// Now write 0xffff words from start+1 to end-1.
		for(i = addr0 + 1; i <= addr1 - 1; i++)
		{
			WRITE_WORD_MODE(buff, i, 0xffff, mode);
		}
	}
}

/**
 * write_hline_lm: write both level and mask buffers.
 *
 * @param	x0		x0 coordinate
 * @param	x1		x1 coordinate
 * @param	y		y coordinate
 * @param	lmode	0 = clear, 1 = set, 2 = toggle
 * @param	mmode	0 = clear, 1 = set, 2 = toggle
 */
void write_hline_lm(unsigned int x0, unsigned int x1, unsigned int y, int lmode, int mmode)
{
	// TODO: an optimisation would compute the masks and apply to
	// both buffers simultaneously.
	write_hline(draw_buffer_level, x0, x1, y, lmode);
	write_hline(draw_buffer_mask, x0, x1, y, mmode);
}

/**
 * write_hline_outlined: outlined horizontal line with varying endcaps
 * Always uses draw buffer.
 *
 * @param	x0			x0 coordinate
 * @param	x1			x1 coordinate
 * @param	y			y coordinate
 * @param	endcap0		0 = none, 1 = single pixel, 2 = full cap
 * @param	endcap1		0 = none, 1 = single pixel, 2 = full cap
 * @param	mode		0 = black outline, white body, 1 = white outline, black body
 * @param	mmode		0 = clear, 1 = set, 2 = toggle
 */
void write_hline_outlined(unsigned int x0, unsigned int x1, unsigned int y, int endcap0, int endcap1, int mode, int mmode)
{
	int stroke, fill;
	SETUP_STROKE_FILL(stroke, fill, mode)
	if(x0 > x1) 
	{
		SWAP(x0, x1);
	}
	// Draw the main body of the line.
	write_hline_lm(x0 + 1, x1 - 1, y - 1, stroke, mmode); 
	write_hline_lm(x0 + 1, x1 - 1, y + 1, stroke, mmode);
	write_hline_lm(x0 + 1, x1 - 1, y, fill, mmode);
	// Draw the endcaps, if any.
	DRAW_ENDCAP_HLINE(endcap0, x0, y, stroke, fill, mmode);
	DRAW_ENDCAP_HLINE(endcap1, x1, y, stroke, fill, mmode);
}

/**
 * swap_buffers: Swaps the two buffers. Contents in the display
 * buffer is seen on the output and the display buffer becomes
 * the new draw buffer.
 */
void swap_buffers()
{
	// While we could use XOR swap this is more reliable and
	// dependable and it's only called a few times per second.
	// Many compliers should optimise these to EXCH instructions.
	uint16_t *tmp;
	SWAP_BUFFS(tmp, disp_buffer_mask, draw_buffer_mask);
	SWAP_BUFFS(tmp, disp_buffer_level, draw_buffer_level);
}

/**
 * buffer_mode: Switch between single and double buffering.
 *
 * @param	mode	0 = single, 1 = double
 */
void buffer_mode(int mode)
{
	if(mode == 0)
	{
		draw_buffer_level = buffer0_level;
		draw_buffer_mask = buffer0_mask;
		disp_buffer_level = buffer0_level;
		disp_buffer_mask = buffer0_mask;
	}
	else if(mode == 1)
	{
		draw_buffer_level = buffer0_level;
		draw_buffer_mask = buffer0_mask;
		disp_buffer_level = buffer1_level;
		disp_buffer_mask = buffer1_mask;
	}
}

/**
 * write_vline: optimised vertical line writing algorithm
 *
 * @param	buff	pointer to buffer to write in
 * @param	x		x coordinate
 * @param	y0		y0 coordinate
 * @param	y1		y1 coordinate
 * @param	mode	0 = clear, 1 = set, 2 = toggle
 */
void write_vline(uint16_t *buff, unsigned int x, unsigned int y0, unsigned int y1, int mode)
{
	unsigned int a;
	CLIP_COORDS(x, y0);
	CLIP_COORDS(x, y1);
	if(y0 > y1)
	{
		SWAP(y0, y1);
	}
	if(y0 == y1) return;
	/* This is an optimised algorithm for writing vertical lines. 
	 * We begin by finding the addresses of the x,y0 and x,y1 points. */
	int addr0 = CALC_BUFF_ADDR(x, y0);
	int addr1 = CALC_BUFF_ADDR(x, y1);
	/* Then we calculate the pixel data to be written. */
	int bitnum = CALC_BIT_IN_WORD(x);
	uint16_t mask = 1 << (15 - bitnum);
	/* Run from addr0 to addr1 placing pixels. Increment by the number
	 * of words n each graphics line. */
	for(a = addr0; a <= addr1; a += DISP_WIDTH / 16)
	{
		WRITE_WORD_MODE(buff, a, mask, mode);
	}
}

/**
 * write_vline_lm: write both level and mask buffers.
 *
 * @param	x		x coordinate
 * @param	y0		y0 coordinate
 * @param	y1		y1 coordinate
 * @param	lmode	0 = clear, 1 = set, 2 = toggle
 * @param	mmode	0 = clear, 1 = set, 2 = toggle
 */
void write_vline_lm(unsigned int x, unsigned int y0, unsigned int y1, int lmode, int mmode)
{
	// TODO: an optimisation would compute the masks and apply to
	// both buffers simultaneously.
	write_vline(draw_buffer_level, x, y0, y1, lmode);
	write_vline(draw_buffer_mask, x, y0, y1, mmode);
}

/**
 * write_vline_outlined: outlined vertical line with varying endcaps
 * Always uses draw buffer.
 *
 * @param	x			x coordinate
 * @param	y0			y0 coordinate
 * @param	y1			y1 coordinate
 * @param	endcap0		0 = none, 1 = single pixel, 2 = full cap
 * @param	endcap1		0 = none, 1 = single pixel, 2 = full cap
 * @param	mode		0 = black outline, white body, 1 = white outline, black body
 * @param	mmode		0 = clear, 1 = set, 2 = toggle
 */
void write_vline_outlined(unsigned int x, unsigned int y0, unsigned int y1, int endcap0, int endcap1, int mode, int mmode)
{
	int stroke, fill;
	if(y0 > y1)
	{
		SWAP(y0, y1);
	}
	SETUP_STROKE_FILL(stroke, fill, mode);
	// Draw the main body of the line.
	write_vline_lm(x - 1, y0 + 1, y1 - 1, stroke, mmode); 
	write_vline_lm(x + 1, y0 + 1, y1 - 1, stroke, mmode);
	write_vline_lm(x, y0 + 1, y1 - 1, fill, mmode);
	// Draw the endcaps, if any.
	DRAW_ENDCAP_VLINE(endcap0, x, y0, stroke, fill, mmode);
	DRAW_ENDCAP_VLINE(endcap1, x, y1, stroke, fill, mmode);
}

/**
 * write_filled_rectangle: draw a filled rectangle.
 *
 * Uses an optimised algorithm which is similar to the horizontal 
 * line writing algorithm, but optimised for writing the lines 
 * multiple times without recalculating lots of stuff.
 *
 * @param	buff	pointer to buffer to write in
 * @param	x		x coordinate (left)
 * @param	y		y coordinate (top)
 * @param	width	rectangle width
 * @param	height	rectangle height
 * @param	mode	0 = clear, 1 = set, 2 = toggle
 */
void write_filled_rectangle(uint16_t *buff, unsigned int x, unsigned int y, unsigned int width, unsigned int height, int mode)
{
	int yy, addr0_old, addr1_old;
	CHECK_COORDS(x, y);
	CHECK_COORD_X(x + width);
	CHECK_COORD_Y(y + height);
	if(width <= 0 || height <= 0) return;
	// Calculate as if the rectangle was only a horizontal line. We then
	// step these addresses through each row until we iterate `height` times. 
	int addr0 = CALC_BUFF_ADDR(x, y);
	int addr1 = CALC_BUFF_ADDR(x + width, y);
	int addr0_bit = CALC_BIT_IN_WORD(x);
	int addr1_bit = CALC_BIT_IN_WORD(x + width);
	int mask, mask_l, mask_r, i;
	// If the addresses are equal, we need to write one word vertically.
	if(addr0 == addr1)
	{
		mask = COMPUTE_HLINE_ISLAND_MASK(addr0_bit, addr1_bit);
		while(height--)
		{
			WRITE_WORD_MODE(buff, addr0, mask, mode);
			addr0 += DISP_WIDTH / 16;
		}
	}
	// Otherwise we need to write the edges and then the middle repeatedly. 
	else
	{
		mask_l = COMPUTE_HLINE_EDGE_L_MASK(addr0_bit);
		mask_r = COMPUTE_HLINE_EDGE_R_MASK(addr1_bit);
		// Write edges first.
		yy = 0;
		addr0_old = addr0;
		addr1_old = addr1;
		while(yy < height)
		{
			WRITE_WORD_MODE(buff, addr0, mask_l, mode);
			WRITE_WORD_MODE(buff, addr1, mask_r, mode);
			addr0 += DISP_WIDTH / 16;
			addr1 += DISP_WIDTH / 16;
			yy++;
		}
		// Now write 0xffff words from start+1 to end-1 for each row.
		yy = 0;
		addr0 = addr0_old;
		addr1 = addr1_old;
		while(yy < height)
		{
			for(i = addr0 + 1; i <= addr1 - 1; i++)
			{
				WRITE_WORD_MODE(buff, i, 0xffff, mode);
			}
			addr0 += DISP_WIDTH / 16;
			addr1 += DISP_WIDTH / 16;
			yy++;
		}
	}
}

/**
 * write_filled_rectangle_lm: draw a filled rectangle on both draw buffers.
 *
 * @param	x		x coordinate (left)
 * @param	y		y coordinate (top)
 * @param	width	rectangle width
 * @param	height	rectangle height
 * @param	lmode	0 = clear, 1 = set, 2 = toggle
 * @param	mmode	0 = clear, 1 = set, 2 = toggle
 */
void write_filled_rectangle_lm(unsigned int x, unsigned int y, unsigned int width, unsigned int height, int lmode, int mmode)
{
	write_filled_rectangle(draw_buffer_mask, x, y, width, height, mmode);
	write_filled_rectangle(draw_buffer_level, x, y, width, height, lmode);
}

/**
 * write_rectangle_outlined: draw an outline of a rectangle. Essentially
 * a convenience wrapper for draw_hline_outlined and draw_vline_outlined.
 *
 * @param	x		x coordinate (left)
 * @param	y		y coordinate (top)
 * @param	width	rectangle width
 * @param	height	rectangle height
 * @param	mode	0 = black outline, white body, 1 = white outline, black body
 * @param	mmode	0 = clear, 1 = set, 2 = toggle
 */
void write_rectangle_outlined(unsigned int x, unsigned int y, int width, int height, int mode, int mmode)
{
	//CHECK_COORDS(x, y);
	//CHECK_COORDS(x + width, y + height);
	//if((x + width) > DISP_WIDTH) width = DISP_WIDTH - x;
	//if((y + height) > DISP_HEIGHT) height = DISP_HEIGHT - y;
	write_hline_outlined(x, x + width, y, ENDCAP_ROUND, ENDCAP_ROUND, mode, mmode);
	write_hline_outlined(x, x + width, y + height, ENDCAP_ROUND, ENDCAP_ROUND, mode, mmode);
	write_vline_outlined(x, y, y + height, ENDCAP_ROUND, ENDCAP_ROUND, mode, mmode);
	write_vline_outlined(x + width, y, y + height, ENDCAP_ROUND, ENDCAP_ROUND, mode, mmode);
}

/**
 * write_circle: draw the outline of a circle on a given buffer,
 * with an optional dash pattern for the line instead of a normal line.
 *
 * @param	buff	pointer to buffer to write in
 * @param	cx		origin x coordinate
 * @param	cy		origin y coordinate
 * @param	r		radius
 * @param	dashp	dash period (pixels) - zero for no dash
 * @param	mode	0 = clear, 1 = set, 2 = toggle
 */
void write_circle(uint16_t *buff, unsigned int cx, unsigned int cy, unsigned int r, unsigned int dashp, int mode)
{
	CHECK_COORDS(cx, cy);
	int error = -r, x = r, y = 0;
	while(x >= y)
	{
		if(dashp == 0 || (y % dashp) < (dashp / 2))
		{
			CIRCLE_PLOT_8(buff, cx, cy, x, y, mode);
		}
		error += (y * 2) + 1;
		y++;
		if(error >= 0)
		{
			--x;
			error -= x * 2;
		}
	}
}

/**
 * write_circle_outlined: draw an outlined circle on the draw buffer.
 *
 * @param	cx		origin x coordinate
 * @param	cy		origin y coordinate
 * @param	r		radius
 * @param	dashp	dash period (pixels) - zero for no dash
 * @param	bmode	0 = 4-neighbour border, 1 = 8-neighbour border
 * @param	mode	0 = black outline, white body, 1 = white outline, black body
 * @param	mmode	0 = clear, 1 = set, 2 = toggle
 */
void write_circle_outlined(unsigned int cx, unsigned int cy, unsigned int r, unsigned int dashp, int bmode, int mode, int mmode)
{
	int stroke, fill;
	CHECK_COORDS(cx, cy);
	SETUP_STROKE_FILL(stroke, fill, mode);
	// This is a two step procedure. First, we draw the outline of the 
	// circle, then we draw the inner part.
	int error = -r, x = r, y = 0;
	while(x >= y)
	{
		if(dashp == 0 || (y % dashp) < (dashp / 2))
		{
			CIRCLE_PLOT_8(draw_buffer_mask, cx, cy, x + 1, y, mmode);
			CIRCLE_PLOT_8(draw_buffer_level, cx, cy, x + 1, y, stroke);
			CIRCLE_PLOT_8(draw_buffer_mask, cx, cy, x, y + 1, mmode);
			CIRCLE_PLOT_8(draw_buffer_level, cx, cy, x, y + 1, stroke);
			CIRCLE_PLOT_8(draw_buffer_mask, cx, cy, x - 1, y, mmode);
			CIRCLE_PLOT_8(draw_buffer_level, cx, cy, x - 1, y, stroke);
			CIRCLE_PLOT_8(draw_buffer_mask, cx, cy, x, y - 1, mmode);
			CIRCLE_PLOT_8(draw_buffer_level, cx, cy, x, y - 1, stroke);
			if(bmode == 1)
			{
				CIRCLE_PLOT_8(draw_buffer_mask, cx, cy, x + 1, y + 1, mmode);
				CIRCLE_PLOT_8(draw_buffer_level, cx, cy, x + 1, y + 1, stroke);
				CIRCLE_PLOT_8(draw_buffer_mask, cx, cy, x - 1, y - 1, mmode);
				CIRCLE_PLOT_8(draw_buffer_level, cx, cy, x - 1, y - 1, stroke);
			}
		}
		error += (y * 2) + 1;
		y++;
		if(error >= 0)
		{
			--x;
			error -= x * 2;
		}
	}
	error = -r;
	x = r;
	y = 0;
	while(x >= y)
	{
		if(dashp == 0 || (y % dashp) < (dashp / 2))
		{
			CIRCLE_PLOT_8(draw_buffer_mask, cx, cy, x, y, mmode);
			CIRCLE_PLOT_8(draw_buffer_level, cx, cy, x, y, fill);
		}
		error += (y * 2) + 1;
		y++;
		if(error >= 0)
		{
			--x;
			error -= x * 2;
		}
	}
}

/**
 * write_circle_filled: fill a circle on a given buffer.
 *
 * @param	buff	pointer to buffer to write in
 * @param	cx		origin x coordinate
 * @param	cy		origin y coordinate
 * @param	r		radius
 * @param	mode	0 = clear, 1 = set, 2 = toggle
 */
void write_circle_filled(uint16_t *buff, unsigned int cx, unsigned int cy, unsigned int r, int mode)
{
	CHECK_COORDS(cx, cy);
	int error = -r, x = r, y = 0, xch = 0;
	// It turns out that filled circles can take advantage of the midpoint
	// circle algorithm. We simply draw very fast horizontal lines across each
	// pair of X,Y coordinates. In some cases, this can even be faster than 
	// drawing an outlined circle!
	//
	// Due to multiple writes to each set of pixels, we have a special exception
	// for when using the toggling draw mode.
	while(x >= y)
	{
		if(y != 0)
		{
			write_hline(buff, cx - x, cx + x, cy + y, mode);
			write_hline(buff, cx - x, cx + x, cy - y, mode);
			if(mode != 2 || (mode == 2 && xch && (cx - x) != (cx - y)))
			{
				write_hline(buff, cx - y, cx + y, cy + x, mode);
				write_hline(buff, cx - y, cx + y, cy - x, mode);
				xch = 0;
			}
		}
		error += (y * 2) + 1;
		y++;
		if(error >= 0)
		{
			--x;
			xch = 1;
			error -= x * 2;
		}
	}
	// Handle toggle mode.
	if(mode == 2)
	{
		write_hline(buff, cx - r, cx + r, cy, mode);
	}
}

/**
 * write_line: Draw a line of arbitrary angle.
 *
 * @param	buff	pointer to buffer to write in
 * @param	x0		first x coordinate
 * @param	y0		first y coordinate
 * @param	x1		second x coordinate
 * @param	y1		second y coordinate
 * @param	mode	0 = clear, 1 = set, 2 = toggle
 */
void write_line(uint16_t *buff, unsigned int x0, unsigned int y0, unsigned int x1, unsigned int y1, int mode)
{
	// Based on http://en.wikipedia.org/wiki/Bresenham%27s_line_algorithm
	int steep = abs(y1 - y0) > abs(x1 - x0);
	if(steep)
	{
		SWAP(x0, y0);
		SWAP(x1, y1);
	}
	if(x0 > x1)
	{
		SWAP(x0, x1);
		SWAP(y0, y1);
	}
	int deltax = x1 - x0;
	int deltay = abs(y1 - y0);
	int error = deltax / 2;
	int ystep;
	int y = y0;
	int x, lasty = y, stox = 0;
	if(y0 < y1)
		ystep = 1;
	else
		ystep = -1;
	for(x = x0; x < x1; x++)
	{
		if(steep)
		{
			if(lasty != y)
			{
				if(x > lasty) 
					write_vline(buff, stox, y, lasty, mode);
				else
					write_vline(buff, stox, lasty, y, mode);
				lasty = y;
				stox = x;
			}
		}
		else
		{
			//write_pixel(buff, x, y, mode);
			/*
			if(lasty != y)
			{
				if(y > lasty) 
					write_vline(buff, stox, y, lasty, mode);
				else
					write_vline(buff, stox, lasty, y, mode);
				lasty = y;
				stox = x;
			}
			*/
		}
		error -= deltay;
		if(error < 0)
		{
			y += ystep;
			error += deltax;
		}
	}
}

/**
 * write_line_lm: Draw a line of arbitrary angle.
 *
 * @param	x0		first x coordinate
 * @param	y0		first y coordinate
 * @param	x1		second x coordinate
 * @param	y1		second y coordinate
 * @param	mmode	0 = clear, 1 = set, 2 = toggle
 * @param	lmode	0 = clear, 1 = set, 2 = toggle
 */
void write_line_lm(unsigned int x0, unsigned int y0, unsigned int x1, unsigned int y1, int mmode, int lmode)
{
	write_line(draw_buffer_mask, x0, y0, x1, y1, mmode);
	write_line(draw_buffer_level, x0, y0, x1, y1, lmode);
}

/**
 * write_line_outlined: Draw a line of arbitrary angle, with an outline.
 *
 * @param	buff		pointer to buffer to write in
 * @param	x0			first x coordinate
 * @param	y0			first y coordinate
 * @param	x1			second x coordinate
 * @param	y1			second y coordinate
 * @param	endcap0		0 = none, 1 = single pixel, 2 = full cap
 * @param	endcap1		0 = none, 1 = single pixel, 2 = full cap
 * @param	mode		0 = black outline, white body, 1 = white outline, black body
 * @param	mmode		0 = clear, 1 = set, 2 = toggle
 */
void write_line_outlined(unsigned int x0, unsigned int y0, unsigned int x1, unsigned int y1, int endcap0, int endcap1, int mode, int mmode)
{
	// Based on http://en.wikipedia.org/wiki/Bresenham%27s_line_algorithm
	// This could be improved for speed.
	int omode, imode;
	if(mode == 0) 
	{
		omode = 0;
		imode = 1;
	}
	else
	{
		omode = 1;
		imode = 0;
	}
	int steep = abs(y1 - y0) > abs(x1 - x0);
	if(steep)
	{
		SWAP(x0, y0);
		SWAP(x1, y1);
	}
	if(x0 > x1)
	{
		SWAP(x0, x1);
		SWAP(y0, y1);
	}
	int deltax = x1 - x0;
	int deltay = abs(y1 - y0);
	int error = deltax / 2;
	int ystep;
	int y = y0;
	int x;
	if(y0 < y1)
		ystep = 1;
	else
		ystep = -1;
	// Draw the outline.
	for(x = x0; x < x1; x++)
	{
		if(steep)
		{
			write_pixel_lm(y - 1, x, mmode, omode);
			write_pixel_lm(y + 1, x, mmode, omode);
			write_pixel_lm(y, x - 1, mmode, omode);
			write_pixel_lm(y, x + 1, mmode, omode);
		}
		else
		{
			write_pixel_lm(x - 1, y, mmode, omode);
			write_pixel_lm(x + 1, y, mmode, omode);
			write_pixel_lm(x, y - 1, mmode, omode);
			write_pixel_lm(x, y + 1, mmode, omode);
		}
		error -= deltay;
		if(error < 0)
		{
			y += ystep;
			error += deltax;
		}
	}
	// Now draw the innards.
	error = deltax / 2;
	y = y0;
	for(x = x0; x < x1; x++)
	{
		if(steep)
		{
			write_pixel_lm(y, x, mmode, imode);
		}
		else
		{
			write_pixel_lm(x, y, mmode, imode);
		}
		error -= deltay;
		if(error < 0)
		{
			y += ystep;
			error += deltax;
		}
	}
}

/**
 * write_word_misaligned: Write a misaligned word across two addresses
 * with an x offset.
 *
 * This allows for many pixels to be set in one write.
 *
 * @param	buff	buffer to write in
 * @param	word	word to write (16 bits)
 * @param	addr	address of first word
 * @param	xoff	x offset (0-15)
 * @param	mode	0 = clear, 1 = set, 2 = toggle
 */
void write_word_misaligned(uint16_t *buff, uint16_t word, unsigned int addr, unsigned int xoff, int mode)
{
	uint16_t firstmask = word >> xoff;
	uint16_t lastmask = word << (16 - xoff);
	WRITE_WORD_MODE(buff, addr, firstmask, mode);
	if(xoff > 0)
	{
		WRITE_WORD_MODE(buff, addr + 1, lastmask, mode);
	}
}

/**
 * write_word_misaligned_NAND: Write a misaligned word across two addresses
 * with an x offset, using a NAND mask.
 *
 * This allows for many pixels to be set in one write.
 *
 * @param	buff	buffer to write in
 * @param	word	word to write (16 bits)
 * @param	addr	address of first word
 * @param	xoff	x offset (0-15)
 *
 * This is identical to calling write_word_misaligned with a mode of 0 but
 * it doesn't go through a lot of switch logic which slows down text writing
 * a lot.
 */
void write_word_misaligned_NAND(uint16_t *buff, uint16_t word, unsigned int addr, unsigned int xoff)
{
	uint16_t firstmask = word >> xoff;
	uint16_t lastmask = word << (16 - xoff);
	WRITE_WORD_NAND(buff, addr, firstmask);
	if(xoff > 0)
	{
		WRITE_WORD_NAND(buff, addr + 1, lastmask);
	}
}

/**
 * write_word_misaligned_OR: Write a misaligned word across two addresses
 * with an x offset, using an OR mask.
 *
 * This allows for many pixels to be set in one write.
 *
 * @param	buff	buffer to write in
 * @param	word	word to write (16 bits)
 * @param	addr	address of first word
 * @param	xoff	x offset (0-15)
 *
 * This is identical to calling write_word_misaligned with a mode of 1 but
 * it doesn't go through a lot of switch logic which slows down text writing 
 * a lot.
 */
void write_word_misaligned_OR(uint16_t *buff, uint16_t word, unsigned int addr, unsigned int xoff)
{
	uint16_t firstmask = word >> xoff;
	uint16_t lastmask = word << (16 - xoff);
	WRITE_WORD_OR(buff, addr, firstmask);
	if(xoff > 0)
	{
		WRITE_WORD_OR(buff, addr + 1, lastmask);
	}
}

/**
 * write_word_misaligned_lm: Write a misaligned word across two 
 * words, in both level and mask buffers. This is core to the text
 * writing routines.
 *
 * @param	buff	buffer to write in
 * @param	word	word to write (16 bits)
 * @param	addr	address of first word
 * @param	xoff	x offset (0-15)
 * @param	lmode	0 = clear, 1 = set, 2 = toggle
 * @param	mmode	0 = clear, 1 = set, 2 = toggle
 */
void write_word_misaligned_lm(uint16_t wordl, uint16_t wordm, unsigned int addr, unsigned int xoff, int lmode, int mmode)
{
	write_word_misaligned(draw_buffer_level, wordl, addr, xoff, lmode);
	write_word_misaligned(draw_buffer_mask, wordm, addr, xoff, mmode);
}

/**
 * fetch_font_info: Fetch font info structs.
 *
 * @param	ch		character
 * @param	font	font id
 */
int fetch_font_info(char ch, int font, struct FontEntry *font_info, char *lookup)
{
	// First locate the font struct.
	if(font > SIZEOF_ARRAY(fonts))
		return 0; // font does not exist, exit.
	// Load the font info; IDs are always sequential.
	*font_info = fonts[font];
	// Locate character in font lookup table. (If required.)
	if(lookup != NULL)
	{
		*lookup = font_info->lookup[ch];
		if(*lookup == 0xff)
			return 0; // character doesn't exist, don't bother writing it.
	}
	return 1;
}

/**
 * write_char: Draw a character on the current draw buffer.
 * Currently supports outlined characters and characters with 
 * a width of up to 8 pixels.
 *
 * @param	ch		character to write
 * @param	x		x coordinate (left)
 * @param	y		y coordinate (top)
 * @param	flags	flags to write with (see gfx.h)
 * @param	font	font to use
 */
void write_char(char ch, unsigned int x, unsigned int y, int flags, int font)
{
	int yy, addr_temp, row, row_temp, xshift;
	uint16_t and_mask, or_mask, level_bits;
	struct FontEntry font_info;
	char lookup;
	fetch_font_info(ch, font, &font_info, &lookup);
	// Compute starting address (for x,y) of character.
	int addr = CALC_BUFF_ADDR(x, y);
	int wbit = CALC_BIT_IN_WORD(x);
	// If font only supports lowercase or uppercase, make the letter 
	// lowercase or uppercase.
	if(font_info.flags & FONT_LOWERCASE_ONLY)
		ch = tolower(ch);
	if(font_info.flags & FONT_UPPERCASE_ONLY)
		ch = toupper(ch);
	fetch_font_info(ch, font, &font_info, &lookup);
	// How big is the character? We handle characters up to 8 pixels
	// wide for now. Support for large characters may be added in future.
	if(font_info.width <= 8)
	{
		// Ensure we don't overflow.
		if(x + wbit > DISP_WIDTH) 
			return;
		// Load data pointer.
		row = lookup * font_info.height * 2;
		row_temp = row;
		addr_temp = addr;
		xshift = 16 - font_info.width;
		// We can write mask words easily.
		for(yy = y; yy < y + font_info.height; yy++)
		{
			write_word_misaligned_OR(draw_buffer_mask, font_info.data[row] << xshift, addr, wbit);
			addr += DISP_WIDTH / 16;
			row++;
		}
		// Level bits are more complicated. We need to set or clear
		// level bits, but only where the mask bit is set; otherwise,
		// we need to leave them alone. To do this, for each word, we
		// construct an AND mask and an OR mask, and apply each individually.
		row = row_temp;
		addr = addr_temp;
		for(yy = y; yy < y + font_info.height; yy++)
		{
			level_bits = font_info.data[row + font_info.height];
			if(!(flags & FONT_INVERT)) // data is normally inverted
				level_bits = ~level_bits;
			or_mask = font_info.data[row] << xshift;
			and_mask = (font_info.data[row] & level_bits) << xshift;
			write_word_misaligned_OR(draw_buffer_level, or_mask, addr, wbit);
			// If we're not bold write the AND mask.
			//if(!(flags & FONT_BOLD))
				write_word_misaligned_NAND(draw_buffer_level, and_mask, addr, wbit);
			addr += DISP_WIDTH / 16;
			row++;
		}
	}
}

/**
 * calc_text_dimensions: Calculate the dimensions of a 
 * string in a given font. Supports new lines and
 * carriage returns in text.
 *
 * @param	str			string to calculate dimensions of
 * @param	font_info	font info structure
 * @param	xs			horizontal spacing
 * @param	ys			vertical spacing
 * @param	dim			return result: struct FontDimensions
 */
void calc_text_dimensions(char *str, struct FontEntry font, int xs, int ys, struct FontDimensions *dim)
{
	int max_length = 0, line_length = 0, lines = 1;
	while(*str != 0)
	{
		line_length++;
		if(*str == '\n' || *str == '\r')
		{
			if(line_length > max_length)
				max_length = line_length;
			line_length = 0;
			lines++;
		}
		str++;
	}
	if(line_length > max_length)
		max_length = line_length;
	dim->width = max_length * (font.width + xs);
	dim->height = lines * (font.height + ys);
}

/**
 * write_string: Draw a string on the screen with certain
 * alignment parameters.
 *
 * @param	str		string to write
 * @param	x		x coordinate
 * @param	y		y coordinate
 * @param	xs		horizontal spacing
 * @param	ys		horizontal spacing
 * @param	va 		vertical align
 * @param	ha		horizontal align
 * @param	flags	flags (passed to write_char)
 * @param	font	font
 */
void write_string(char *str, unsigned int x, unsigned int y, unsigned int xs, unsigned int ys, int va, int ha, int flags, int font)
{
	int xx = 0, yy = 0, xx_original = 0;
	struct FontEntry font_info;
	struct FontDimensions dim;
	// Determine font info and dimensions/position of the string.
	fetch_font_info(0, font, &font_info, NULL);
	calc_text_dimensions(str, font_info, xs, ys, &dim);
	switch(va)
	{
		case TEXT_VA_TOP: 		yy = y; break;
		case TEXT_VA_MIDDLE:	yy = y - (dim.height / 2); break;
		case TEXT_VA_BOTTOM: 	yy = y - dim.height; break;
	}
	switch(ha)
	{
		case TEXT_HA_LEFT:		xx = x; break;
		case TEXT_HA_CENTER:	xx = x - (dim.width / 2); break;
		case TEXT_HA_RIGHT:		xx = x - dim.width; break;
	}
	// Then write each character.
	xx_original = xx;
	while(*str != 0)
	{
		if(*str == '\n' || *str == '\r')
		{
			yy += ys + font_info.height;
			xx = xx_original;
		}
		else
		{
			if(xx >= 0 && xx < DISP_WIDTH)
				write_char(*str, xx, yy, flags, font);
			xx += font_info.width + xs;
		}
		str++;
	}
}

/**
 * write_string_formatted: Draw a string with format escape
 * sequences in it. Allows for complex text effects.
 *
 * @param	str		string to write (with format data)
 * @param	x		x coordinate
 * @param	y		y coordinate
 * @param	xs		default horizontal spacing
 * @param	ys		default horizontal spacing
 * @param	va 		vertical align
 * @param	ha		horizontal align
 * @param	flags	flags (passed to write_char)
 */
void write_string_formatted(char *str, unsigned int x, unsigned int y, unsigned int xs, unsigned int ys, int va, int ha, int flags)
{
	int fcode = 0, fptr, font = 0, fwidth, fheight, xx = x, yy = y, max_xx = 0, max_height = 0;
	struct FontEntry font_info;
	// Retrieve sizes of the fonts: bigfont and smallfont.
	fetch_font_info(0, 0, &font_info, NULL); 
	int smallfontwidth = font_info.width, smallfontheight = font_info.height;
	fetch_font_info(0, 1, &font_info, NULL); 
	int bigfontwidth = font_info.width, bigfontheight = font_info.height;
	// 11 byte stack with last byte as NUL.
	char fstack[11]; 
	fstack[10] = '\0'; 
	// First, we need to parse the string for format characters and
	// work out a bounding box. We'll parse again for the final output.
	// This is a simple state machine parser.
	char *ostr = str;
	while(*str)
	{
		if(*str == '<' && fcode == 1) // escape code: skip
			fcode = 0;
		if(*str == '<' && fcode == 0) // begin format code?
		{
			fcode = 1; 
			fptr = 0;
		}
		if(*str == '>' && fcode == 1)
		{
			fcode = 0;
			if(strcmp(fstack, "B")) // switch to "big" font (font #1)
			{
				fwidth = bigfontwidth;
				fheight = bigfontheight;
			}
			else if(strcmp(fstack, "S")) // switch to "small" font (font #0)
			{
				fwidth = smallfontwidth;
				fheight = smallfontheight;
			}
			if(fheight > max_height) 
				max_height = fheight;
			// Skip over this byte. Go to next byte.
			str++;
			continue;
		}
		if(*str != '<' && *str != '>' && fcode == 1)
		{
			// Add to the format stack (up to 10 bytes.)
			if(fptr > 10) // stop adding bytes
			{
				str++; // go to next byte
				continue;
			}
			fstack[fptr++] = *str;
			fstack[fptr] = '\0'; // clear next byte (ready for next char or to terminate string.)
		}
		if(fcode == 0)
		{
			// Not a format code, raw text. 
			xx += fwidth + xs;
			if(*str == '\n')
			{
				if(xx > max_xx) 
					max_xx = xx;
				xx = x;
				yy += fheight + ys;
			}
		}
		str++;
	}
	// Reset string pointer.
	str = ostr;
	// Now we've parsed it and got a bbox, we need to work out the dimensions of it
	// and how to align it.
	int width = max_xx - x;
	int height = yy - y;
	int ay, ax;
	switch(va)
	{
		case TEXT_VA_TOP: 		ay = yy; break;
		case TEXT_VA_MIDDLE:	ay = yy - (height / 2); break;
		case TEXT_VA_BOTTOM: 	ay = yy - height; break;
	}
	switch(ha)
	{
		case TEXT_HA_LEFT:		ax = x; break;
		case TEXT_HA_CENTER:	ax = x - (width / 2); break;
		case TEXT_HA_RIGHT:		ax = x - width; break;
	}
	// So ax,ay is our new text origin. Parse the text format again and paint
	// the text on the display.
	fcode = 0;
	fptr = 0;
	font = 0;
	xx = 0;
	yy = 0;
	while(*str)
	{
		if(*str == '<' && fcode == 1) // escape code: skip
			fcode = 0;
		if(*str == '<' && fcode == 0) // begin format code?
		{
			fcode = 1; 
			fptr = 0;
		}
		if(*str == '>' && fcode == 1)
		{
			fcode = 0;
			if(strcmp(fstack, "B")) // switch to "big" font (font #1)
			{
				fwidth = bigfontwidth;
				fheight = bigfontheight;
				font = 1;
			}
			else if(strcmp(fstack, "S")) // switch to "small" font (font #0)
			{
				fwidth = smallfontwidth;
				fheight = smallfontheight;
				font = 0;
			}
			// Skip over this byte. Go to next byte.
			str++;
			continue;
		}
		if(*str != '<' && *str != '>' && fcode == 1)
		{
			// Add to the format stack (up to 10 bytes.)
			if(fptr > 10) // stop adding bytes
			{
				str++; // go to next byte
				continue;
			}
			fstack[fptr++] = *str;
			fstack[fptr] = '\0'; // clear next byte (ready for next char or to terminate string.)
		}
		if(fcode == 0)
		{
			// Not a format code, raw text. So we draw it.
			// TODO - different font sizes.
			write_char(*str, xx, yy + (max_height - fheight), flags, font);
			xx += fwidth + xs;
			if(*str == '\n')
			{
				if(xx > max_xx) 
					max_xx = xx;
				xx = x;
				yy += fheight + ys;
			}
		}
		str++;
	}
}

/**
 * gfx_align_test: Draw alignment markers, for making sure the
 * display is properly aligned. A test routine.
 */
void gfx_align_test()
{
	int y;
	clear_draw();
    write_hline_outlined(0, DISP_WIDTH, 0, 2, 2, 0, 1);
	write_hline_outlined(0, DISP_WIDTH, 16, 2, 2, 0, 1);
	write_hline_outlined(0, DISP_WIDTH, (DISP_HEIGHT / 2) - 10, 2, 2, 0, 1);
	write_hline_outlined(0, DISP_WIDTH, DISP_HEIGHT / 2, 2, 2, 0, 1);
	write_hline_outlined(0, DISP_WIDTH, (DISP_HEIGHT / 2) + 10, 2, 2, 0, 1);
	write_hline_outlined(0, DISP_WIDTH, DISP_HEIGHT - 16, 2, 2, 0, 1);
	write_hline_outlined(0, DISP_WIDTH, DISP_HEIGHT, 2, 2, 0, 1);
	write_vline_outlined(0, 0, DISP_HEIGHT, 2, 2, 0, 1);
	write_vline_outlined(20, 0, DISP_HEIGHT, 2, 2, 0, 1);
	write_vline_outlined(DISP_WIDTH - 20, 0, DISP_HEIGHT, 2, 2, 0, 1);
	write_vline_outlined(DISP_WIDTH, 0, DISP_HEIGHT, 2, 2, 0, 1);
	write_vline_outlined((DISP_WIDTH / 2) - 10, 0, DISP_HEIGHT, 2, 2, 0, 1);
	write_vline_outlined((DISP_WIDTH / 2), 0, DISP_HEIGHT, 2, 2, 0, 1);
	write_vline_outlined((DISP_WIDTH / 2) + 10, 0, DISP_HEIGHT, 2, 2, 0, 1);
	write_circle_outlined(DISP_WIDTH / 2, DISP_HEIGHT / 2, (DISP_HEIGHT / 2) - 16, 10, 1, 0, 1); 
	write_circle_outlined(DISP_WIDTH / 2, DISP_HEIGHT / 2, 10, 0, 1, 0, 1); 
	write_string("DISPLAY ALIGN ", DISP_WIDTH / 2, 30, 1, 1, TEXT_VA_TOP, TEXT_HA_CENTER, 0, 0);
	//write_string("TEST MODE", DISP_WIDTH / 2, DISP_HEIGHT - 30, 1, 1, TEXT_VA_BOTTOM, TEXT_HA_CENTER, 0, 1);
}

/**
 * wait_vsync: If we are set to sync the display to the vsync signal, 
 * then this code will pause the main thread until vsync occurs.
 */
void wait_vsync()
{
	if(use_vsync == 1)
	{
		while(have_vsync_refresh == 0);
		have_vsync_refresh = 0;
	}
}
