Zyrter/super-osd/src/c_images.h

/**
 * Compressed and uncompressed images.
 */

#if 0		// no longer used

const char logo_small[] =  {
	0xff, 0x00, 0xff, 0x00, 0xff, 0x00, 0xff, 0x00, 
	0xff, 0x00, 0xff, 0x00, 0xff, 0x00, 0xff, 0x00, 
	0xff, 0x00, 0xff, 0x00, 0xff, 0x00, 0xff, 0x00, 
	0x20, 0x00, 0x01, 0xf8, 0x01, 0x3f, 0x1c, 0x00, 
	0x01, 0x01, 0x01, 0x00, 0x01, 0xfe, 0x01, 0xff, 
	0x1c, 0x00, 0x01, 0x03, 0x01, 0x00, 0x01, 0x07, 
	0x01, 0xc0, 0x01, 0x00, 0x01, 0x80, 0x1a, 0x00, 
	0x01, 0x0f, 0x01, 0x00, 0x01, 0x01, 0x02, 0x00, 
	0x01, 0xc0, 0x01, 0xff, 0x01, 0x07, 0x18, 0x00, 
	0x01, 0x1c, 0x01, 0x00, 0x01, 0xf0, 0x01, 0x3f, 
	0x01, 0x00, 0x01, 0xe0, 0x01, 0xff, 0x01, 0x1f, 
	0x01, 0x00, 0x01, 0xf0, 0x16, 0x00, 0x01, 0x38, 
	0x01, 0x00, 0x02, 0x7c, 0x01, 0x00, 0x01, 0x30, 
	0x01, 0x00, 0x01, 0x78, 0x01, 0x00, 0x01, 0xfc, 
	0x16, 0x00, 0x01, 0x30, 0x01, 0x00, 0x01, 0x0e, 
	0x01, 0xe0, 0x01, 0x00, 0x01, 0x18, 0x01, 0x00, 
	0x01, 0xe0, 0x01, 0x00, 0x01, 0x1e, 0x01, 0x00, 
	0x01, 0xf8, 0x14, 0x00, 0x01, 0x61, 0x01, 0x00, 
	0x01, 0x07, 0x01, 0xc0, 0x01, 0x01, 0x01, 0x1c, 
	0x01, 0xff, 0x01, 0xc3, 0x01, 0x00, 0x01, 0x06, 
	0x01, 0xf0, 0x01, 0xff, 0x0e, 0x00, 0x01, 0x01, 
	0x02, 0x00, 0x01, 0xe0, 0x01, 0x01, 0x01, 0x00, 
	0x01, 0x63, 0x01, 0xe0, 0x01, 0x03, 0x01, 0x00, 
	0x01, 0x01, 0x01, 0x8c, 0x01, 0x8f, 0x01, 0x87, 
	0x01, 0x01, 0x01, 0xe6, 0x01, 0xff, 0x01, 0x83, 
	0x01, 0x00, 0x01, 0x80, 0x0c, 0x00, 0x01, 0x1f, 
	0x02, 0x00, 0x01, 0xfc, 0x01, 0x8f, 0x01, 0x1f, 
	0x01, 0xc7, 0x01, 0xf0, 0x01, 0x01, 0x01, 0x00, 
	0x01, 0x01, 0x01, 0x86, 0x01, 0x00, 0x01, 0x8e, 
	0x01, 0x01, 0x01, 0xfe, 0x01, 0x07, 0x01, 0x80, 
	0x01, 0x00, 0x01, 0xe0, 0x0c, 0x00, 0x01, 0x7c, 
	0x02, 0x00, 0x01, 0x1f, 0x01, 0xbe, 0x01, 0x1f, 
	0x01, 0xc6, 0x01, 0x10, 0x02, 0x00, 0x01, 0x03, 
	0x01, 0xc6, 0x01, 0x00, 0x01, 0x1c, 0x01, 0x01, 
	0x01, 0x3e, 0x01, 0x00, 0x01, 0x8c, 0x01, 0x00, 
	0x01, 0xf8, 0x0c, 0x00, 0x01, 0xe0, 0x01, 0x01, 
	0x01, 0x80, 0x01, 0x03, 0x01, 0xf0, 0x01, 0x18, 
	0x01, 0x8e, 0x01, 0x11, 0x02, 0x00, 0x01, 0x03, 
	0x01, 0xc6, 0x01, 0x00, 0x01, 0x18, 0x01, 0x01, 
	0x01, 0x0c, 0x01, 0xf8, 0x01, 0x8f, 0x01, 0x00, 
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
};

#endif
