Zyrter/super-osd/src-new/V3.2/console.c

/**
 * Super OSD, software revision 3
 * Copyright (C) 2010 Thomas Oldbury
 *
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
 * You should have received a copy of the GNU General Public License along
 * with this program; if not, write to the Free Software Foundation, Inc.,
 * 51 Franklin Street, Fifth Floor, Boston, MA 02110-1301 USA.
 */

#include <stdio.h>
#include <stdlib.h>
#include <stdarg.h>
#include "osd.h"
#include "console.h"

/*
 * These files manage the virtual console. The console is used for 
 * debugging and on startup. The functions are similar to old DOS 
 * APIs.
 */
// Console is up to 32x24 chars.
struct ConChar cons[32][24];
int con_width, con_height;
struct ConCurs curs;
// What to do when we reach the end of the window.
// 0 = scrolling window (scrolls down)
// 1 = rolling window (resets at top) 
int con_rolling; 

// Private buffer. Not used.
//char printf_buffer[CON_TMPSIZE];

/**
 * con_init: Initialize the console.
 */
void con_init()
{
	unsigned char ch;
	int x, y;
	// Initialize cursor.
	curs.x = 0;
	curs.y = 0;
	// Initialize console size 
	con_width = DISP_WIDTH / 8;
	con_height = DISP_HEIGHT / 8;
	// Demo/test console on startup.
	con_fillscr(0, 0);
	con_puts("Console init", 0);
	for(y = 0; y < con_height; y++)
	{
		for(x = 0; x < con_width; x++)
		{
			con_setchr(x, y, x + (y * con_width), 0);
		}
	}
	con_flush();
	con_fillscr(' ', 0);
	// Reset cursor.
	curs.x = 0;
	curs.y = 0;
	con_flush();
}

/**
 * con_setchr: Set a character at a location without
 * incrementing or moving the console cursor.
 */
void con_setchr(int x, int y, char ch, char attr)
{
	cons[x][y].ch = ch;
	cons[x][y].attr = attr;
	//con_flush();
}

/**
 * con_scrollup: Move the console one line up.
 */
void con_scrollup()
{
	int x, y;
	// Copy each row.
	for(y = 1; y < con_height; y++)
	{
		for(x = 0; x < con_width; x++)
		{
			con_setchr(x, y - 1, cons[x][y].ch, cons[x][y].attr);
		}
	}
	// Delete the bottom row.
	for(x = 0; x < con_width; x++)
		con_setchr(x, con_height - 1, ' ', 0);
}

/**
 * con_fillscr: Fill screen with a character.
 *
 * @param	ch		character to write
 * @param	attr	attributes for character
 */
void con_fillscr(char ch, char attr)
{
	int x, y;
	for(x = 0; x < con_width; x++)
	{
		for(y = 0; y < con_height; y++)
		{
			con_setchr(x, y, ch, attr);
		}
	}
	con_flush();
}

/**
 * con_clrscr: Clear the screen.
 */
void con_clrscr()
{
	con_fillscr(' ', 0);
}

/**
 * con_putchr: Place a character and increment the cursor.
 *
 * @param	ch		character to be written
 * @param	attr	attributes for character
 * @param	flush	whether or not to flush on newline or special character (0 = no, 1 = yes)
 */
void con_putchr(char ch, char attr, char flush)
{
	if(ch == '\n' || ch == '\r')
	{
		// New line.
		curs.y++;
		curs.x = 0;
	}
	else if(ch == '\v')
	{
		// Vertical tab: y increments, x stays the same.
		curs.y++;
	}
	else if(ch == '\t')
	{
		// Horizontal tab support TODO.
	}
	else
	{
		if(curs.x > con_width - 1)
		{
			curs.x = 0;
			curs.y++;
		}
		con_setchr(curs.x, curs.y, ch, attr);
		curs.x++;
	}
	// If y exceeds bounds, scroll up the window.
	if(curs.y > con_height - 1)
	{
		if(flush)
			con_flush();
		if(con_rolling)
			curs.y = 0;
		else
		{
			con_scrollup();
			curs.y = con_height - 1;
		}
	}
}

/**
 * con_puts: Write a string to the console. Newline is
 * automatically added.
 *
 * @param	string	string to be written, newline automatically added
 * @param	attr	attributes for each character
 */
void con_puts(char *s, char attr)
{
	while(*s != '\0')
	{
		con_putchr(*s, attr, 0);
		s++;
	}
	con_putchr('\n', 0, 1);
	con_flush();
}

/**
 * con_puts: Write a string to the console. 
 * Does not flush console.
 *
 * @param	string	string to be written, newline automatically added
 * @param	attr	attributes for each character
 */
void con_puts_noflush(char *s, char attr)
{
	while(*s != '\0')
	{
		con_putchr(*s, attr, 0);
		s++;
	}
	con_putchr('\n', 0, 0);
}

/**
 * con_printf: Write a formatted string to the console.
 * Up to CON_TMPSIZE characters may be written. Newline is
 * **not** automatically added.
 *
 * @param	fmt		format string (as in printf, sprintf...)
 * @param	attr	attributes for each character
 */
/* BROKEN */
#if 0
void con_printf(char *fmt, char attr, ...)
{
	// FIXME: something is not right with this.
	char *s = printf_buffer;
	va_list args;
	va_start(args, attr);
	vsnprintf(s, CON_TMPSIZE, fmt, args);
	va_end(args);
	while(*s != '\0')
	{
		con_putchr(*s, attr, 0);
		s++;
	}
	con_flush();
}
#endif

/**
 * con_flush: Update the display to reflect the current
 * console buffer.
 */
void con_flush()
{
	int x, y;
	// Clear the graphics framebuffers.
	fill_buffer(draw_buffer_mask, 0x0000);
	fill_buffer(draw_buffer_level, 0xffff);
	// Update the framebuffers.
	for(x = 0; x < con_width; x++)
	{
		for(y = 0; y < con_height; y++)
		{
			// Write the character on the display.
			// TODO: handle attributes.
			write_char(cons[x][y].ch, x * 8, y * 8, 0, 1);
		}
	}
	// Switch buffers.
	swap_buffers();
}
