Zyrter/super-osd/src/demo.h

/**
 * This implements several demo.
 *
 * It is written in C because that makes many parts easier.
 */

#ifndef	DEMO_H
#define	DEMO_H

int triangle(int x, unsigned int range);
void demo_intro_text1();
void demo_intro_text2();
void demo_vertical_lines();
void demo_horizontal_lines();
void demo_aligned_text();
int demo();

#endif	// DEMO_H
