Zyrter/super-osd/(commit log)

2010-08-13 added schematics and a few other things
    [Basic Main Board Schematic.sch]
2010-08-14 updated source: demos removed, changes to graphics core (including fixing RTC and topmost graphics glitch), start of HUD (non-modular), no sprintf (save 1K flash); avg 31 fps
    [c_images.h, demo.c, hud.c, hud.h, hudwidgets.h, main.c, osd.h]
2010-08-16 RSSI meter, battery meter for HUD
2010-08-18 Hardware V2 FPV prelim. schematics uploaded
    [FPV_version_PIC18.sch, FPV_version_analog_inputs.sch, FPV_version_external_interface.sch, FPV_version_video_core.sch, Power_supply_section.sch]
2010-08-18 Fix schematics
    [FPV_version_external_interface.sch]
2010-08-19 First PCB revision
    [FPV_version.pcb]
2010-08-20 Final PCB for v2; work starts on v2.a
    [FPV_version.pcb]
2010-08-29 Added v2b (r4) PCB, schematics, gerbers
    [FPV_version_PIC18.sch, FPV_version_analog_inputs.sch, FPV_version_external_interface.sch, FPV_version_video_core.sch, Power_supply_section.sch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]
2010-08-30 Images + BOM
    [FPV_version_analog_inputs.sch, FPV_version_video_core.sch, Power_supply_section.sch, bom.ods, bomlist.csv, v2b.pcb]
2010-08-30 Fixed gerbers
    [v2b.back.gbr, v2b.backmask.gbr, v2b.backpaste.gbr, v2b.backsilk.gbr, v2b.fab.gbr, v2b.front.gbr, v2b.frontmask.gbr, v2b.frontpaste.gbr]
2010-10-29 Added schematics, pcbs, gerbers for V3. Also added voltage reference precision tool (python utility by myself.)
    [CPU.sch, Connectors.sch, OSD.sch, PSU.sch, pcb-v3-lite.pcb]
2010-10-29 Added gerbers (forgot to add on last commit.)
    [pcb-v3-lite.0032.back.gbr, pcb-v3-lite.0032.backmask.gbr, pcb-v3-lite.0032.backpaste.gbr, pcb-v3-lite.0032.backsilk.gbr, pcb-v3-lite.0032.fab.gbr, pcb-v3-lite.0032.front.gbr, pcb-v3-lite.0032.frontmask.gbr, pcb-v3-lite.0032.frontpaste.gbr]
2010-10-29 Updated OSD schematics to include model of Q2 and Q3.
    [OSD.sch]
2010-10-29 Added png's and svg's of pcb layout
2011-01-04 new gerbers, schematics
    [bom-start.csv, buttons-and-illumination.sch, mcu.sch, osd.sch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]
2011-01-09 Updated microcontroller section 0.1% -> 1% resistors Added some overall comments Remarks of DNP on several items
    Also made minor changes to PCB and buttons/illumination section
    [buttons-and-illumination.sch, mcu.sch, pcb-v3-lite.pcb]
2011-01-30 Added factory calibrator, current sensor, and gaming radio.
    [.back.gbr, .backmask.gbr, .backsilk.gbr, .fab.gbr, .front.gbr, .frontmask.gbr, .frontpaste.gbr, .frontsilk.gbr]
2011-01-30 Added schematic png for radio & calibrator
2011-01-30 added pngs for schematics
2011-02-20 Added v3.25 stuff
    [buttons-and-illumination.sch, mcu.sch, osd.sch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]
2011-02-26 Updated 3.25 files - this is version 3.25B, probably the final production version (hah, he says.)
    [buttons-and-illumination.sch, mcu.sch, osd.sch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]
2011-04-19 New HUD, with compass. Minor additional changes. Fixed resolution bug. Improved text algorithm and debug features. General code cleanup.
    [console.c, gfx.c, gfx.h, gfx_game_engine.c, gfx_game_engine.h, hud.c, hud.h, interface.h]
2011-05-30 V3.3 design, including gerbers
    [.back.gbr, .backmask.gbr, .backsilk.gbr, .fab.gbr, .front.gbr, .frontmask.gbr, .frontpaste.gbr, .frontsilk.gbr]
